Aliceykr/ImpedScope/README.md

# STM32 黑盒电路频响辨识

> 适用硬件：STM32H750XBH6，3.3 V 单电源 · 文档版本：2026-10-30，按当前源码、`.ioc`、Keil 工程和实际构建结果编写

## 1. 概述

本工程用一颗 STM32H750XBH6 测量未知一端口网络（DUT）的导纳：

- 外部信号源输出 **1 Vpp、1.65 V 直流偏置** 的正弦，接到 `Ui` 节点；
- DUT 接在 `Ui` 与运放虚地（1.65 V）之间，跨阻放大器把 DUT 电流转换成 `Uo`；
- 两路 ADC 同步采样 `Ui`、`Uo`，在选定频率上做单频 DFT，得到 `H = Uo/Ui`；
- 由 `Y = -H/R_eff`、`Z = -R_eff/H` 计算导纳、阻抗、G、B、φY；
- 固件自动在 **2 档频率（1 kHz / 10 kHz）** 中选择；反馈电阻为 **3 路继电器**，上电闭合 1.5 kΩ 档，可 b1 手动切档或 b2 打开自动量程。结果送串口屏，同时通过 USART3 输出调试日志。

测量范围（任务书指标）：`Re[Y]`、`Im[Y]`、`|Y|` 为 **0.1–10 mS**，误差 ≤10%；`φY` 为 **±90°**，误差 ≤5%。**默认 1.5 kΩ 档覆盖 0.188–1.88 mS；b1 可切 150 Ω / 15 kΩ 档，b2 自动量程会在三档间自动选。0.1–10 mS 全量程仍需按档标定（见 §8、§15）。**

## 2. 系统架构

### 2.1 模拟前端

```text
外部源 ── Ui ── DUT ──┬── 虚地 1.65 V（运放反相端）
 1 Vpp                │
 1.65 V 偏置          └── R（K1/K2/K3 之一，上电默认 K2 = 1.5 kΩ，b1 单击切档）
                             │
                        继电器触点（三路并联，高电平闭合）
                             │
                        运放输出 Uo（直流 1.65 V）
```

- 运放为 3.3 V 单电源、轨到轨；反相端由同相端偏置在 **1.65 V**，所以虚地和 `Uo` 的直流工作点都是 1.65 V。
- `Uo` 的交流摆幅设计为 0.15–1.5 V（围绕 1.65 V），即 0.15–3.15 V，落在 ADC 的 0–3.3 V 内。
- 三路独立继电器（高电平闭合）各串一只反馈电阻，并联在 `Uo` 与虚地之间：**K1=150 Ω / K2=1.5 kΩ / K3=15 kΩ**。
- 本版上电只闭合 **K2**，上电时 `R_eff = 1500 Ω`（b1 单击可切）；继电器接触电阻（<1 Ω）相对最小档 150 Ω 可忽略，按标称值使用。
- GPIO（**PE3/PE4/PE6**）只驱动继电器模块的逻辑输入，模块自带三极管/MOS 驱动与续流。

### 2.2 数字部分

- ADC1/ADC2 双 ADC 规则组同步采样，TIM6 TRGO 触发 300 kHz，CDR 打包 + DMA。
- UART4（921600）驱动串口屏：TX 阻塞发送，RX 单字节中断接收；USART3（921600）输出调试日志，应用层只使用 TX。
- 调试口为 SWD（PA13/PA14），没有调试 UART 复用。
- SPI1 配置为从机模式，通过 DMA 循环接收 FPGA 推送的测量帧，用于与 ADC+DFT 结果并行比对（见 §6）。

## 3. 工程结构

```text
9_30/
├─ USE/
│  ├─ measure.h/.c        测量核心：频率、ADC 采样与单频 DFT、H/Z/Y、标定、应用层循环
│  ├─ screen.h/.c         串口屏 UART4 协议、错误码、b0/b1/b2 按键、按键服务
│  ├─ relay_range.h/.c    三路继电器反馈电阻（b1 单击切档）
│  ├─ spi_slave.h/.c      SPI1 从机驱动：DMA 循环接收 FPGA 帧、CRC 校验、帧解析
│  └─ uart_debug.h/.c     USART3 调试日志（TX-only、环形缓冲、SPI/DFT 比对输出）
├─ Core/
│  ├─ Src/main.c          初始化、主循环（三个高层调用）
│  ├─ Src/usart.c         UART4（屏幕）+ USART3（调试）
│  ├─ Src/adc.c           ADC1/ADC2 双 ADC 同步配置
│  ├─ Src/tim.c           TIM6，TRGO 触发 ADC
│  ├─ Src/spi.c           SPI1 从机模式配置
│  ├─ Src/stm32h7xx_it.c  中断入口（含 ADC/UART4/USART3/SPI DMA）
│  └─ Src/gpio.c          CubeMX 生成的 GPIO
├─ Drivers/               STM32H7 HAL、CMSIS
├─ MDK-ARM/               Keil 工程（40 个源文件）
└─ 9_30.ioc               CubeMX 配置
```

`USE/` 是用户逻辑；CubeMX 重新生成时保留该目录。`relay_range` 和 `uart_debug` 已加入 Keil 的 `Application/User/USE` 组。

**代码分层说明**：
- `measure.c/h`：测量算法 + 应用层循环（Measure_Init, Measure_Service）
- `screen.c/h`：按键处理 + 屏幕显示（Screen_KeyService, Screen_Poll）
- `main.c`：只负责初始化和调用高层函数

## 4. 引脚与资源

| 资源 | 引脚 | 配置 | 用途 |
|---|---|---|---|
| ADC1 | PA0_C | `ADC1_INP0`，模拟 | `Ui` |
| ADC2 | PA1_C | `ADC2_INP1`，模拟 | `Uo` |
| UART4 | PC10 / PC11 | AF8，921600 8N1 | 串口屏 TX/RX |
| USART3 | PB10 / PB11 | AF7，921600 8N1，硬件 TX/RX 初始化；应用层 TX-only | 调试日志 |
| 继电器 K1/K2/K3 | PE3 / PE4 / PE6 | GPIO 推挽输出 | 量程选择（上电默认 K2，b1 单击切档） |
| TIM6 | 内部 | PSC=3，ARR=99 | 300 kHz TRGO |
| SWD | PA13 / PA14 | Serial Wire | 调试/下载 |
| HSE | PH0 / PH1 | 外部晶振 | 系统时钟 |
| LSE | PC14 / PC15 | 32.768 kHz | RTC 备选 |
| SPI1 | PB5 / PG11 / PG9 | MOSI/SCK/MISO | 从机接收 FPGA 数据（PG10 = NSS） |

- PB11 在硬件初始化中保留为 USART3_RX 复用脚，但应用层不调用 `HAL_UART_Receive_IT()` 或接收 DMA；USART3 实际只发送日志。
- PA4 不分配（原 DDS 片选已释放）。
- PG10 配置为 SPI1_NSS 硬件输入（FPGA 提供片选信号）。
- 所有模拟输入为 0–3.3 V 单端，无负压。

## 5. 主循环与数据流

```text
上电
  → HAL/时钟/GPIO/DMA/SPI1/UART4/USART3/ADC1/TIM6/ADC2
  → Screen_Init()            启动 UART4 接收（b0/b1/b2）
  → UartDebug_Init()          调试口就绪，输出 banner
  → Measure_Init()           CircuitID → Relay → ADC → SPI 从机 → 首次扫描
  → 主循环（每轮三个调用）
       Screen_KeyService()   处理按键，设置请求标志
       Measure_Service()     执行扫描或一次测量周期
       Screen_Poll()         每 500 ms 刷新屏幕
```

**架构说明**：
- `Screen_KeyService()`：处理 b0/b1/b2 按键，设置 Measure_RequestScan/NextRange/AutoRangeToggle
- `Measure_Service()`：运行期非阻塞状态机，每次调用执行一小步后立即返回（IDLE/SWEEPING/SWITCHING/MEASURING 四状态互斥）
- `Screen_Poll()`：刷新屏幕显示

**状态机架构**（v3.2 非阻塞改造）：

```
IDLE ──b0/自动──► SWEEPING ──done──► IDLE
  │                    ▲
  │b1                 │B1 abort
  ▼                    │
SWITCHING ─────────────┘
  │
  │done
  ▼
MEASURING ──window ready/timeout──► IDLE
```

- 所有状态在每次 `Measure_Service()` 调用时先检查按键请求，按键响应时间 < 10 ms
- 运行期 ADC 窗口等待、频率扫描、切档均为非阻塞，主循环单次迭代 < 5 ms；`Measure_Init()` 的首次扫描在启动路径中循环等待完成，这是初始化例外。

**按键行为**：
- b0 单击 → 重扫频率（队列中尚未消费的重复 b0 合并为一个待处理事件）
- b1 单击 → 切换继电器档位（1.5k → 15k → 150 → 循环）；自动量程开启时先关闭自动再切档
- b2 单击 → 打开/关闭**自动量程**（见 §8.3），`t10` 末尾出现 ` A` 表示已开启

- 反馈电阻上电固定 1.5 kΩ；b1 单击可循环切档，切档后 `CircuitID_SetFeedbackResistor()` 同步 `R_eff`、丢弃当前窗口并重开。
- 计算失败/超时会清结果，屏幕显示 `-`，不显示陈旧读数。
- b1 在窗口等待期间可提前响应，扫描期间按 b1 立即退出扫描并切档，不闪 E04。

## 6. 测量原理

### 6.1 采样窗口

```text
N = round(100 × fs / f)，限制在 [256, 400000]
fs = 300 kHz
```

窗口覆盖 100 个信号周期：

| f | N | 窗口时长 |
|---|---|---|
| 100 Hz | 300000 | 1 s |
| 300 Hz | 100000 | 333 ms |
| 1 kHz | 30000 | 100 ms |
| 3 kHz | 10000 | 33.3 ms |
| 10 kHz | 3000 | 10 ms |

窗口时长远小于 `MEASURE_WAIT_TIMEOUT_MS = 1500 ms`；100 Hz 的 1 s 也留了 500 ms 余量。

### 6.2 单频 DFT

```text
ω = 2π f / fs
S = Σ (x_n − x̄) · e^(−j ω n)，n = 0 … N−1
x̄ = 窗口平均值（去直流）
|U| = 2 |S| / N        （ADC 码值，峰值）
```

- `S_i` 对应 `Ui`（ADC1），`S_o` 对应 `Uo`（ADC2）。
- 两路共用同一个 N 和同一个块序号，`H = Uo/Ui` 与归一化无关。

### 6.3 相干性判据

```text
kappa = |U| / (sqrt(2) · RMS_ac)
```

- 纯单频：`kappa = 1.0`；纯噪声：`kappa ≈ sqrt(2/N)`（N=30000 时约 0.008）。
- `kappa < CIR_MIN_COHERENCE`（0.2）→ `Ui` 报 E14、`Uo` 报 E15。
- 幅值下限：`|Ui| < 4` 码 → E04；`|Uo| < 4` 码 → E05。两个门限是占位值，待实测调整。

### 6.4 传递函数、阻抗、导纳

```text
H = Uo / Ui
Z = -R_eff / H
Y = -H / R_eff
G = Re[Y]，B = Im[Y]
```

- `H` 的 dB/相位由 `20·log10(|H|)` 和 `atan2(H_im, H_re)` 得到。
- `|H| < CIR_H_MIN_MAG`（1e-6）→ E08；Z/Y 非有限 → E09。
- `R_eff` 由 `relay_range` 提供，上电恒为 1500 Ω；b1 单击可切为 150/1500/15000 Ω，见第 8、9、13 节。
- 两路 ADC 的增益/相位差由 `s_calib[]` 修正，见第 13 节。

### 6.5 数值示例

1 µF 电容，`R_eff = 115 Ω`（15 Ω 档），1 kHz，源 1 Vpp（`Ui` 峰值 0.5 V）：

```text
Y   = jωC ≈ j 6.283 mS
|Y| ≈ 6.283 mS，φY = +90°，G = 0，B ≈ +6.283 mS
H   = -Y·R_eff ≈ -j 1.571（4.08 dB，-90°）
Uo 峰值 = 0.5 V × 1.571 ≈ 0.785 V（不削顶）
|Z| = 1/|Y| ≈ 159 Ω
```

## 7. 自动选频

`FreqScanStep()` 在启动和按 b0 时推进扫描：

- 候选顺序：`1 kHz, 10 kHz`；
- 每个候选开一个窗口，算 `Ui` 的单频幅值 `ui_mag` 和相干性 `ui_coh`；
- 打分 `score = ui_mag × ui_coh`，要求 `ui_mag > CIR_INPUT_MIN_AMP` 且 `ui_coh > 0.5`；
- 取最高分；某档 `ui_coh > 0.95` 时提前结束；
- 全部不合格时回到 1 kHz 并返回 0，主循环报 E04。

选频只依赖 `Ui`，与反馈电阻无关；量程默认 1.5 kΩ，由 b1 单击手动切换，无需选档。`Measure_SetFrequency()` 可覆盖频率，范围 100–100000 Hz；外部源必须同步到当前频率。运行期扫描由 `Measure_Service()` 分步推进，扫描期间 b1 可中止扫描；两档扫描的采样等待总时长约 0.11 s，但不会在一次主循环调用中阻塞。

## 8. 继电器量程（三档，上电默认 1.5 kΩ）

### 8.1 三路继电器与档位

| 通道 | GPIO | 电阻 | 上电后状态 | 覆盖 \|Y\|（Uo 0.15–1.5 V，参考） |
|---|---|---|---|---|
| K1 | PE3 | 150 Ω | 断开（低） | 1.2–12 mS |
| K2 | PE4 | 1.5 kΩ | **闭合（高，默认档）** | 0.188–1.88 mS |
| K3 | PE6 | 15 kΩ | 断开（低） | 19.9–198.7 µS |

- 高电平 = 继电器线圈得电 = 触点闭合；低电平/GND = 断开。三路**独立**，任意时刻最多闭合一路。
- 每路：`Uo → 继电器触点 → 反馈电阻 → 虚地（1.65 V）`，三路并联；触点只承受小信号（≤1.5 V、≤5 mA）。
- 继电器接触电阻通常 0.05–0.5 Ω，相对最小档 150 Ω 可忽略，`R_eff` 直接按标称值。
- GPIO 只驱动继电器模块的逻辑输入（模块自带三极管/MOS 驱动与续流），不要直接驱动裸线圈。

### 8.2 上电时序与运行期切档

- `MX_GPIO_Init()`（CubeMX 生成）配 PE3/PE4/PE6 为推挽输出并写低；`Relay_Init()` 只做上电时序：三路全低（断开）→ 等 10 ms 释放 → 只把 PE4 拉高（K2 = 1.5 kΩ）→ 等 10 ms 吸合。
- `CircuitID_SetFeedbackResistor(Relay_GetOhm())` 同步固定 `R_eff = 1500 Ω`，与 `s_calib`（Rf=1500）和 `CIR_FEEDBACK_RESISTOR_OHM` 对齐。
- **不做自动量程**（默认）；运行期切档由 b1 单击触发（`Relay_NextAsync()`，1.5k → 15k → 150 → 1.5k 循环）。b2 可打开自动量程，见 §8.3。
- 上电三路全断到 K2 闭合之间 TIA 开环、`Uo` 可能撞轨；`Relay_Init()` 在 `ADC_Sampler_Init()` 之前完成，不会采到无效窗口。

### 8.3 自动量程（b2 开关）

- b2 单击切换：**按一下开、再按一下关**；开启后 `t10` 显示 `R:1.5k A`。
- 每完成一个窗口评估一次，按 **`Uo` 峰值最接近半量程（0.8 V）** 选档：
  ```
  Uo_pred(i) = Uo_meas × R[i] / R[cur]        （同一 DUT、同一频率下 |Y| 不变）
  在 Uo_pred ≤ MEASURE_AR_MAX_V(1.5 V) 的候选里，选 |ln(Uo_pred / 0.8)| 最小的档
  ```
  `Uo` 落在半量程，意味着 ADC 用了约 50% 可用摆幅，同时 `|Y|·Rf` 也处在合适量级——两个“最佳范围”是同一个条件。
- **降增益立即执行**（削顶时 `Uo` 饱和、外推不可信，只退一档）；**升增益需连续 2 个窗口确认**，防止在临界点来回跳。
- `Uo` 低于 `MEASURE_AR_MIN_CODE`（4 码）视为没有信号，不参与选档，交给 `CircuitID_Compute()` 报 E05。
- 三档都放不下（`|Y|` > 约 12 mS 或 < 约 20 µS）时选最接近的档继续测，E19/E20/E05 照常上报，自动模式保持开启。
- 自动模式下按 b1：**先关闭自动，再切到下一档**（手动接管）。
- 复位后自动关闭、回到 1.5 kΩ；运行期切档使用 `Relay_NextAsync()`，先释放、等待 10 ms，再吸合目标档并等待 10 ms。两个等待阶段由 `SWITCHING` 状态分散到多次主循环调用中，不阻塞主循环；切档完成后丢弃当前窗口并重新启动采样。

## 9. SPI 从机与双路并行（FPGA 数据接收）

### 9.1 概述

SPI1 配置为从机模式，通过 DMA 循环接收 FPGA 推送的测量帧。每个测量周期：
- DFT 值照常输出到串口屏
- SPI 帧换算成 Y 并与 DFT 值比对，结论只写 USART3 日志
- SPI 超时/持续坏帧 → 报错误码 E21，DFT 路径不受影响（双路并行）

### 9.2 硬件连接

```text
FPGA (Master)                    STM32H750 (Slave)
  MOSI  ───────────────────────►  PB5   (SPI1_MOSI，从机时是输入)
  SCK   ───────────────────────►  PG11  (SPI1_SCK，从机时是输入)
  CS    ───────────────────────►  PG10  (SPI1_NSS，硬件输入，低有效)
  MISO  ◄───────────────────────  PG9   (可选；本阶段 H7 不发，保持高阻/悬空)
  GND   ────────────────────────  GND   (必须共地)
```

### 9.3 帧协议

- 单位：16 位字（SPI1 配的是 16 位帧）
- 位序：MSB first；32 位量拆成高字在前、低字在后
- 一帧 = 10 个字 = 20 字节
- 每帧独立，帧间无间隔要求；FPGA 只需保证 CS 一帧拉低一次

**⚠️ 关键：CS 不能用来对齐帧**

固件不会在 CS 上升沿重置 DMA 位置 —— DMA 只是按字计数，4 帧循环。

- 帧边界靠"每帧固定 10 字"维持，不靠 CS
- 一旦多/少一个 16 位字，后面全错位，只能靠"连续 4 帧失败 → HAL_SPI_Abort + 重挂 DMA"恢复
- **FPGA 必须保证 CS 拉低的整个区间里恰好发 160 个 SCK，不能中间断**

**示例帧**（`|H|=1.500000`，`φ=-11.860°`，`f=1000`，`seq=1`，`flags=0x0005`）：

```text
A55A 0001 0005 0000 03E8 0016 E360 FFFF D1AC <crc>
```

- `1.5e6 = 0x0016E360` → `word5=0x0016`、`word6=0xE360`
- `-11860 = 0xFFFFD1AC` → `word7=0xFFFF`、`word8=0xD1AC`
- `flags=0x0005` = bit0（有效）+ bit2（频率有效）
- `<crc>` 由 FPGA 按下方规则计算

| Word | 字段 | 类型 | 说明 |
|---|---|---|---|
| 0 | `HEAD` | `0xA55A` | 帧头，固定 |
| 1 | `seq` | u16 | 帧序号，每帧 +1，溢出回绕 |
| 2 | `flags` | u16 | bit0=本帧有效；bit1=FPGA 侧削顶；bit2=频率字段有效 |
| 3 | `f_hi` | u16 | 频率 Hz，高 16 位 |
| 4 | `f_lo` | u16 | 频率 Hz，低 16 位 |
| 5 | `mag_hi` | u16 | `\|H\| × 1e6`（u32），高 16 位 |
| 6 | `mag_lo` | u16 | 同上，低 16 位 |
| 7 | `phi_hi` | u16 | `φH`，单位毫度（int32，补码），高 16 位 |
| 8 | `phi_lo` | u16 | 同上，低 16 位 |
| 9 | `crc` | u16 | CRC-16/CCITT-FALSE，初值 0xFFFF，多项式 0x1021 |

**⚠️ CRC 字节序：必须按线上顺序（大端）计算**

Cortex-M7 是小端，`0xA55A` 在内存里是 `5A A5`，但 SPI 线上 MSB first 发的是 `A5 5A`。

固件算 CRC 时按**线上字节顺序**（大端）喂数据，FPGA 侧必须保持一致：

- **正确做法**：把 10 个字（word0..word9）按字节流 `A5 5A 00 01 ...` 喂给 CRC 函数
- **错误做法**：按内存小端序（`5A A5 ...`）喂 CRC —— 会导致"帧头对、CRC 全错"，容易误判成时序问题

FPGA 实现时：每个 16 位字先发高字节、再发低字节，CRC 按这个字节流顺序计算。

### 9.4 调试输出

通过 USART3 输出 SPI 调试信息，编译期分级宏控制：

| 等级 | 输出内容 | 默认 |
|---|---|---|
| LEVEL=0 | 全关（量产） | ✗ |
| LEVEL=1 | 初始化 + 错误 + 每秒统计（稳态约 1 行/秒） | ✓ |
| LEVEL=2 | 额外按时间节流打印 SPIRX（联调用，10 行/秒） | ✗ |
| LEVEL=3 | 再额外 dump SPIRAW 原始字（查字对齐/位序） | ✗ |

**关键约束**：
- 限速靠时间，不靠帧数（避免高帧率时刷爆日志缓冲）
- DMA 回调里只累加计数、置标志，所有打印只在主循环上下文发出
- 联调完必须把等级降回 1（避免挤占测量日志）

### 9.5 测试用例

| # | 用例 | 预期 |
|---|---|---|
| S1 | FPGA 持续发帧 | `ok` 递增、`err/ovr=0`；USART3 每测量周期一行 `SPI ...` |
| S2 | 拔掉 FPGA | 200 ms 后屏上出现 E21，DFT 结果照常刷新；插回后 E21 自动消失 |
| S3 | 故意发错 CRC | `err` 递增，坏帧不被采用（`seq` 不前进） |
| S4 | 先断后接导致字错位 | 连续 4 帧失败后自动重同步，恢复出数 |
| S5 | 接 1 kΩ 0.1% 电阻 | `dY_permille` < 20（2%）、`dP_mdeg` < 200（0.2°） |
| S6 | 切档（b1）后再测 | SPI 结果随之变化，无异常帧 |
| S7 | 自动量程开启（b2） | 行为不变，SPI 只记录 |
| S8 | 长时间运行 30 min | 无 OVR 累积、无内存越界 |

## 10. 串口屏（UART4）

- UART4，**921600 8N1**，PC10 TX / PC11 RX。TX 使用 `HAL_UART_Transmit()` 阻塞发送；RX 使用 `HAL_UART_Receive_IT()` 单字节中断接收；DMA 不使用。
- 每 500 ms 发一整帧 `t0`–`t10`，每条 `控件名.txt="值"` + `FF FF FF`；条间留 2 ms 给 HMI 重绘。
- 屏幕只显示，频率由固件自动选择；b0 单击 = 强制重扫，b1 单击 = 切换继电器档位，b2 单击 = 自动量程开关。

| 控件 | 内容 | 示例 |
|---|---|---|
| `t0` | 频率（Hz） | `f:1000`，无结果显示 `f:-` |
| `t1` | `\|Y\|`（mS） | `Y:1.000` |
| `t2` | φY（°） | `P:-12.34` |
| `t3` | G = Re[Y]（mS） | `G:0.977` |
| `t4` | B = Im[Y]（mS） | `B:-0.213` |
| `t5` | 阶段或最近错误 | `stage:LOOP`、`stage:E12 WINDOW_TIMEOUT x12` |
| `t6` | 心跳，每帧 +1 | `beat:1234` |
| `t7` | `Ui` 交流有效值（V）与 kappa | `Ui:0.1234V k:0.98` |
| `t8` | `Uo` 交流有效值（V）与 kappa | `Uo:0.0988V k:0.97` |
| `t9` | H 的幅值（dB） | `H:-3.97dB` |
| `t10` | 当前反馈电阻档位 | `R:1.5k` |

- `t1`–`t4` 依赖 `CIR_DUT_TOPOLOGY=1`；设为 0（只算 H）时这四行固定显示 `-`。
- 阶段顺序：`BOOT → CLK → PERIPH → MODULE → SCAN → LOOP`；`BOOT`/`CLK` 在 UART 就绪前，屏幕不可见；`PERIPH` 起可见，且保持约 150 ms。
- 按键协议为**单字节**（`0x01`/`0x02`/`0x03`），UART4 接收中断直接映射成事件入队，`Screen_PollKey()` 每轮出队一个；运行期即使正在等待 DFT 窗口，按键也保留在队列中，不依赖阻塞式扫描：
  - b0：`0x01`（`printh 01`）：单击强制重扫频率，档位不变；
  - b1：`0x02`（`printh 02`）：单击切换继电器档位（1.5k → 15k → 150 → 1.5k），频率不变；切档由 `Relay_NextAsync()` 推进，完成后调用 `CircuitID_SetFeedbackResistor()` / `Screen_ClearResult()` / `Screen_ClearError()` / `Screen_FlushRange()` / `ADC_Sampler_Restart()`；
  - b2：`0x03`（`printh 03`）：单击打开/关闭自动量程（`t10` 末尾出现/去掉 ` A`）。
- 100 ms 防抖窗口从上一次通过识别的按键事件开始计时：小于 100 ms 的重复事件丢弃，达到 100 ms 的新事件允许通过；因此同一次点击里的重复字节（如 `03 03 03`）通常只算一次，但**不要混发不同字节**（如 `01 01 02`）作为一组协议。
- b0 额外做合并/去重：尚未出队时只保留一个待处理事件；事件出队时清除 pending 标志，因此后续 b0 仍可再次触发重扫。
- b1 只在按下事件发送一次；HMI 释放事件必须为空，否则一次点击会触发两次。
- 档位在 `t10` 显示为 `R:150 / R:1.5k / R:15k`；切档时 `Screen_FlushRange()` 立即补发 `t10`，不等 500 ms 整帧。`Screen_SetActiveFreq()` 只更新当前频率、清上一频率结果并强制下一帧刷新。

## 10. 调试串口（USART3）

- **USART3，PB10 TX / PB11 RX（AF7），921600 8N1**；硬件初始化为 TX/RX，但应用层只调用 `HAL_UART_Transmit_IT()`，不启动 USART3 接收流程，因此 PB11 浮空不会形成应用层 RXNE 接收中断路径。
- 当前实际 NVIC 配置为：`USART3_IRQn=(0,0)`、`UART4_IRQn=(0,0)`、`SPI1_IRQn=(0,0)`、`DMA1_Stream2_IRQn=(0,0)`、`DMA1_Stream1_IRQn=(0,0)`、`DMA1_Stream0_IRQn=(1,0)`；ADC 错误中断在运行时设置为 `ADC_IRQn=(5,0)`。这与“USART3=5、DMA=0”的设计意图并不完全一致，属于优先级配置未完全落地，当前没有证据表明会静默破坏 DFT。
- `DMA_PRIORITY_LOW` 是 DMA 控制器内部优先级，不等同于 NVIC 抢占优先级。
- 发送：1024 字节环形缓冲 + `HAL_UART_Transmit_IT()`；主循环只拷贝，不阻塞；缓冲满整行丢弃并计数。
- 速率：每次有效测量一行，最小间隔 `UART_DEBUG_MIN_INTERVAL_MS = 200 ms`（5 Hz）。
- 只发不收，没有下行命令；标定写入/表格导出仍需另加协议。

日志格式（CSV，整数单位，不用 `%f`）：

```text
f=1000,Y_uS=1000,P_mdeg=-12300,G_uS=977,B_uS=-213,H_dB_x100=408,H_deg_x100=16770,R_ohm=1500,range=1,Ui_rms_mV=354,Uo_rms_mV=566
```

- `Y_uS/G_uS/B_uS`：µS（1 mS = 1000 µS）
- `P_mdeg`：毫度（-12.3° → -12300）
- `H_dB_x100 / H_deg_x100`：dB×100、度×100
- `R_ohm`：当前 `R_eff`
- `range`：0=150 Ω、1=1.5 kΩ、2=15 kΩ（当前档位，随切档变化）
- `Ui_rms_mV / Uo_rms_mV`：去直流后的交流有效值（mV）

上电 banner：

```text
BOOT 9_30 debug uart 921600
```

接线：USB-TTL 的 **RX → PB10**，**GND → GND**。若 921600 误码，改 `.ioc` 的 `USART3.BaudRate` 和 `usart.c` 中的 921600 为 115200。USART3 出错时 `screen.c` 的 `HAL_UART_ErrorCallback()` 会清理标志并调用 `UartDebug_OnError()` 重启发送。

## 11. ADC 采样

### 11.1 通道

| 通道 | 引脚 | ADC 通道 | 含义 |
|---|---|---|---|
| ADC1（主） | PA0_C | `ADC1_INP0` | `Ui` |
| ADC2（从） | PA1_C | `ADC2_INP1` | `Uo` |

`_C` 为直连快速通道，经 SYSCFG 模拟开关接入；PA0_C/PA1_C 与普通 PA0/PA1 是两个焊盘。

### 11.2 时序

- 双 ADC 规则组同步模式（`ADC_DUALMODE_REGSIMULT`），16 位，`32_10_BITS` 打包。
- TIM6 TRGO 上升沿同时启动两路；PSC=3、ARR=99、120 MHz → **300 kHz**。
- 采样时间 **1.5 个 ADC 周期**（37.5 MHz 下 40 ns）；16 位转换 8.5 周期，总计约 267 ns，远小于 3.33 µs 触发周期。
- ADC 时钟 PLL2 75 MHz / 2 = **37.5 MHz**。HSE=25 MHz 时，PLL2 输入为 `25/2=12.5 MHz`，VCO 为 `12.5×12=150 MHz`，P/Q/R 输出均为 75 MHz。
- 只有 ADC1 的 DMA（DMA1_Stream2，32 位字、循环）搬运 CDR；ADC2 的 DMA 配置保留但同步模式下不启动。
- 每半个缓冲区 64 对样本回调一次。

### 11.3 初始化与保护

- `ADC_Sampler_Init()`：回读 CCR 校验同步模式/打包格式（不符返回 2 → E16 致命）→ 两路 offset/linearity 校准 → `HAL_ADCEx_MultiModeStart_DMA()` → 使能 `ADC_IRQn` → 启动 TIM6。
- OVR（E17）或 DMA 错误（E18）会作废当前窗口；由 `HAL_ADC_ErrorCallback()` 置弃窗标志，`ADC_Sampler_TryFinish()` 丢弃，不置 ready。
- 溢出/DMA 错误不终止测量，主循环等下一个干净窗口。

### 11.4 接口

| 函数 | 说明 |
|---|---|
| `ADC_Sampler_Init()` | 校准、启动同步转换和 TIM6；返回 0/1/2 |
| `ADC_Sampler_SetFrequency(f)` | 设定频率并开新窗口；同频不重开；非法返回 0 |
| `ADC_Sampler_GetWindow(&w)` | 取出已完成窗口；无新窗口返回 0 |
| `ADC_Sampler_Restart()` | 以当前频率强制重开窗口；换档后调用 |
| `ADC_Window_t` | `frequency_hz`、`sample_count`、`ui_re/im`、`uo_re/im`、`ui_rms/uo_rms`、`clip` |

改采样率时必须同时改 TIM6 的 PSC/ARR 和 `ADC_SAMPLER_RATE_HZ`，否则 DFT 频率轴静默错位。

### 11.5 DMA 内存位置与中断优先级

- 当前命令行构建使用的 scatter file 将 RW/ZI 分配到 `RW_IRAM1=0x20000000`（DTCM）和 `RW_IRAM2=0x24000000`（AXI SRAM）。
- 实际 armlink map 中，ADC 双缓冲 `adc_pair_buf` 位于 `0x24000084`，SPI DMA 缓冲 `s_dma_buf` 位于 `0x240007e4`，均在 AXI SRAM；本次构建的 DTCM 区没有放入这些关键 DMA 缓冲。
- 结论：当前不存在“DMA buffer 落在 DTCM、DMA1 不可达”的问题，不需要因此修改硬件或强行增加 section 属性。
- PLL2 VCO 当前为 **150 MHz**，处于 HAL 注释给出的 `RCC_PLL2VCOMEDIUM` 范围 `150–420 MHz` 的下边界；代码计算和当前 HAL 范围允许。仍建议上板时结合目标芯片数据手册、温度和电源条件确认锁定稳定性，当前不据此修改配置。
### 11.6 削波检测

- 统计窗口内贴边样本：码值 `≤ CIR_CLIP_LOW_CODES (64)` 或 `≥ CIR_CLIP_HIGH_CODES (65471)`；
- 贴边比例 > `CIR_CLIP_MAX_PERMILLE (1%)` → `Ui` 报 E19、`Uo` 报 E20；
- 削顶时波形仍完整，结果照常计算/显示，但提示不可信；E17/E18 才是必须弃窗的失效。
- 局限：只能抓 ADC 端贴边；运放先饱和（ADC 尚未贴边）抓不到，仍需把前端偏置/幅度做对。

## 12. 参数配置

| 宏 | 文件 | 默认 | 说明 |
|---|---|---|---|
| `ADC_SAMPLER_RATE_HZ` | `measure.h` | 300000 | DFT 频率轴（必须与 TIM6 一致） |
| `ADC_SAMPLER_PAIRS_PER_HALF` | `measure.h` | 64 | 每个 DMA 半缓冲的采样对数 |
| `ADC_SAMPLER_WINDOW_CYCLES` | `measure.h` | 100 | 窗口覆盖的信号周期数 |
| `ADC_SAMPLER_WINDOW_MIN/MAX` | `measure.h` | 256 / 400000 | 窗口点数上下限 |
| `ADC_SAMPLER_VREF_V` | `measure.h` | 3.3 | VREF+/VDDA，只影响 t7/t8 电压 |
| `CIR_DUT_TOPOLOGY` | `measure.h` | 1 | 1=算 Z/Y；0=只算 H |
| `CIR_FEEDBACK_RESISTOR_OHM` | `measure.h` | 1500.0 | 固定反馈电阻（relay_range 同步后使用） |
| `CIR_INPUT_MIN_AMP` / `CIR_OUTPUT_MIN_AMP` | `measure.h` | 4.0 | 幅值下限（码值，占位） |
| `CIR_MIN_COHERENCE` | `measure.h` | 0.2 | 相干性下限 |
| `CIR_H_MIN_MAG` | `measure.h` | 1e-6 | `|H|` 下限 |
| `CIR_CLIP_LOW/HIGH_CODES` | `measure.h` | 64 / 65471 | 贴边码值 |
| `CIR_CLIP_MAX_PERMILLE` | `measure.h` | 10 | 贴边比例上限（1%） |
| `RELAY_COUNT` | `relay_range.h` | 3 | 继电器档位数 |
| `RELAY_DEFAULT_INDEX` | `relay_range.h` | 1 | 默认档（K2 = 1.5 kΩ） |
| `RELAY_SETTLE_MS` / `RELAY_RELEASE_MS` | `relay_range.h` | 10 / 10 | 吸合建立 / 释放等待（ms） |
| `Relay_SetAsync()` / `Relay_NextAsync()` | `relay_range.h` | — | 运行期非阻塞切档 / 切到下一档（b1 单击触发） |
| `MEASURE_AR_TARGET_V` | `measure.h` | 0.8 | 自动量程目标 `Uo` 峰值（半量程） |
| `MEASURE_AR_MAX_V` | `measure.h` | 1.5 | 自动量程允许的最大预测 `Uo`（超过就判为会削顶） |
| `MEASURE_AR_MIN_CODE` | `measure.h` | 4.0 | 低于此码值视为没信号，不参与选档 |
| `MEASURE_AR_UPSHIFT_WINDOWS` | `measure.h` | 2 | 升增益需要的连续确认窗口数 |
| `UART_DEBUG_ENABLE` | `uart_debug.h` | 1 | 调试日志开关 |
| `UART_DEBUG_MIN_INTERVAL_MS` | `uart_debug.h` | 200 | 日志最小间隔（ms） |
| `UART_DEBUG_TX_BUFFER_SIZE` | `uart_debug.h` | 1024 | 发送环形缓冲（字节） |
| `MEASURE_WAIT_TIMEOUT_MS` | `main.c` | 1500 | 单窗口等待上限（ms） |
| `SCREEN_REFRESH_PERIOD_MS` | `screen.h` | 500 | 串口屏刷新周期（ms） |

## 13. 标定

### 13.1 反馈电阻

上电默认闭合 K2（1.5 kΩ），`R_eff` 由 `CircuitID_SetFeedbackResistor(Relay_GetOhm())` 同步；
1.5 kΩ 档已标定，继电器接触电阻（<1 Ω）可忽略。b1 切到 150 Ω / 15 kΩ 档后需按档重标 `R_eff`。

### 13.2 两路直通 H_thru

把 `Ui` 和 `Uo` 短接到同一信号源，理论上 `H = 1`（0 dB、0°）；实测偏差就是两路增益比与相位差：

```text
H_true(f) = H_meas(f) / H_thru(f)
mag_ratio = 1 / |H_thru|
phase_deg = angle(H_thru)
```

- 1.5 kΩ 档按**逐频点**做即可；切到 150 Ω / 15 kΩ 档后 C_off 随档位变化，这两档的 H_thru 需逐档重做。
- 标定时窗口长度、采样率、频率必须与实际测量一致。

### 13.3 当前标定表

`s_calib[]` 目前有两项，在 **1.5 kΩ 反馈**（即本版默认档）下测得，直接适用：

| 频率 | mag_ratio | phase_deg |
|---|---|---|
| 1 kHz | 1.009 | -1.186° |
| 10 kHz | 1.031 | -11.559° |

`Calib_Lookup()` 是**就近取值、不插值**，只标 1k/10k 时 100/300/3k 会取最近点。

## 14. 错误码

非致命错误由 `Screen_ReportError()` 计数，`t5` 显示最近错误和累计次数；新阶段/新错误覆盖显示。致命错误由 `Screen_Fatal()`/`Error_Handler()` 触发，关中断后阻塞发送，`t5` 锁定。

| 码 | 名称 | 位置 | 触发条件 | 类型 |
|---|---|---|---|---|
| E01 | HAL_INIT | `MX_*_Init()`、`ADC_Sampler_Init()` | 外设初始化/校准/DMA 启动失败 | 致命 |
| E02 | CIR_CFG | `measure.c` | `R_eff ≤ 0`、频率 0、窗口空 | 非致命 |
| E03 | CIR_NAN_IN | `measure.c` | Ui/Uo 分量非有限 | 非致命 |
| E04 | CIR_UI_LOW | `measure.c` | `\|Ui\| < CIR_INPUT_MIN_AMP` | 非致命 |
| E05 | CIR_UO_LOW | `measure.c` | `\|Uo\| < CIR_OUTPUT_MIN_AMP` | 非致命 |
| E06 | CIR_H_NAN | `measure.c` | H 非有限 | 非致命 |
| E07 | CIR_OUT_NAN | `measure.c` | 频率/dB/相位输出非有限 | 非致命 |
| E08 | CIR_H_LOW | `measure.c` | `\|H\| < CIR_H_MIN_MAG` | 非致命 |
| E09 | CIR_ZY_NAN | `measure.c` | Z/Y 非有限 | 非致命 |
| E10 | UART_TX | `screen.c` | UART4 发送失败 | 非致命 |
| E11 | UART_BUSY | — | 保留：当前 UART4 TX 为阻塞发送，不走忙状态错误路径 | — |
| E12 | WINDOW_TIMEOUT | `main.c` | 等 ADC 窗口超时 | 非致命 |
| E13 | — | — | 已停用，保留编号 | — |
| E14 | CIR_UI_INCOH | `measure.c` | `Ui` 非单频（kappa < 0.2） | 非致命 |
| E15 | CIR_UO_INCOH | `measure.c` | `Uo` 非单频（kappa < 0.2） | 非致命 |
| E16 | ADC_DUAL_MODE | `measure.c` | 双 ADC 同步/打包格式回读不符 | 致命 |
| E17 | ADC_OVR | `measure.c` | ADC 溢出，弃窗 | 非致命 |
| E18 | ADC_DMA | `measure.c` | ADC DMA 错误，弃窗 | 非致命 |
| E19 | ADC_CLIP_UI | `measure.c` | `Ui` 削顶 | 非致命 |
| E20 | ADC_CLIP_UO | `measure.c` | `Uo` 削顶 | 非致命 |
| E21 | SPI_LINK | `measure.c` | SPI 从机链路超时（>200 ms 无有效帧） | 非致命 |

时钟配置失败发生在 UART 就绪前，屏幕无法显示，只能用调试器定位。

## 15. 已知限制

- **默认只测 1.5 kΩ 档**：覆盖约 0.188–1.88 mS；b1 单击可切 150 Ω / 15 kΩ 档（约 1.2–12 mS / 19.9–198.7 µS），0.1–10 mS 全量程仍需按档标定 `R_eff`。
- **继电器模块依赖外部硬件**：必须高电平闭合、GPIO 只接模块逻辑输入；若模块低有效或上电吸合，需改硬件或在 `Relay_Write()` 反转（见 §8）。
- **上电三路全断 → TIA 开环**：`Relay_Init()` 必须在 `ADC_Sampler_Init()` 之前完成；复位/上电期间模块输入建议加 10 kΩ 下拉。
- **自动选频耗时**：扫描两档约 0.11 s。
- **外部源频率/直流不在固件控制内**：源频率偏离会导致 κ 下降/相位误差；源直流中点必须是 1.65 V，否则 DUT 上会有 1.65 V 直流，TIA 可能饱和。
- **幅值门限是占位值**：`CIR_INPUT_MIN_AMP`/`CIR_OUTPUT_MIN_AMP = 4` 码，需按实际噪声调整。
- **调试串口只发不收**：USART3 应用层只使用 TX，没有下行命令；PB11 虽保留硬件 RX 复用，但未启动接收流程。
- **档位在 t10 显示**：`R:150 / R:1.5k / R:15k`（当前档，切档后立即更新）；更细的 `R_eff` 可从 USART3 日志的 `range`/`R_ohm` 看。
- **两路增益/相位只标了 1.5 kΩ 档**：默认档 `s_calib` 直接适用；b1 切到 150 Ω / 15 kΩ 档后绝对值只可信到相对变化，需按档重标。
- **扫描期间按键**：运行期扫描由 `FreqScanStep()` 分步推进，b1 可中止扫描并切档；尚未出队的重复 b0 会合并为一个待处理事件。

## 16. 编译与维护

- Keil MDK-ARM 打开 `MDK-ARM/9_30.uvprojx`；ArmClang V6.24（`.uvprojx` 的 `pArmCC` 已钉到该版本）。
- CubeMX 6.18，HAL FW 1.13；系统时钟 480 MHz，HCLK 120 MHz，APB 60 MHz；ADC 37.5 MHz；SPI1 75 MHz。
- 当前 **40 个源文件**，含 `relay_range.c`、`uart_debug.c`、`spi_slave.c`。
- 命令行构建：

```bash
bash .ccg-build/build.sh <outdir>
```

CubeMX 重新生成后检查：

1. Keil 工程仍包含 `measure.c`、`screen.c`、`relay_range.c`、`uart_debug.c`，头文件路径含 `../USE`。
2. `.ioc`：PE3/PE4/PE6 为 `GPIO_Output`（标签 `RELAY_K1/K2/K3`）；PB10 为 `USART3_TX`；UART4/USART3 均 921600；UART4/USART3 全局中断使能。
3. `main.c` USER CODE 区：
   - USER CODE BEGIN 2: `Screen_Init()`, `UartDebug_Init()`, `Measure_Init()`
   - USER CODE BEGIN WHILE: `Screen_KeyService()`, `Measure_Service()`, `Screen_Poll()`
4. `adc.c` 的 `ADC_DUALMODE_REGSIMULT`/`DualModeData`/`TwoSamplingDelay` 仍在 `USER CODE BEGIN ADC1_Init 2` 区；ADC1 的 DMA 为 Word 对齐。
5. TIM6 的 PSC/ARR 与 `ADC_SAMPLER_RATE_HZ` 一致；SPI1 为从机模式，DMA 循环接收 FPGA 帧。
6. `relay_range.c`、`uart_debug.c`、`spi_slave.c` 在 `Application/User/USE` 组。

**代码架构说明**：
- `main.c` 只负责初始化和调用三个高层函数
- 按键逻辑在 `screen.c` 的 `Screen_KeyService()`
- 测量逻辑在 `measure.c` 的 `Measure_Service()`
- 屏幕刷新在 `screen.c` 的 `Screen_Poll()`

## 17. 验证状态

已通过：

- ArmClang 命令行编译 + 链接：**40 个源文件，0 个编译/链接错误**；Program Size：Code=58826、RO-data=2542、RW-data=28、ZI-data=5540。构建过程中有 legacy armasm deprecated 提示，不影响生成固件。
- `.ccg-build/verify.sh` 全量检查通过（PASS），包括 40 个源文件、当前 scatter 内存布局、关键外设配置和生成代码一致性检查。
- `.ioc` 与代码的引脚/实例一致性检查：PE3/PE4/PE6（`RELAY_K1/K2/K3`）、PB10/USART3、PC10/11/UART4。
- 固件源码（`USE/`、`Core/`）静态检查：无 `analog_switch` / `Switch_*` / `SW_ENABLE` / `Screen_TakeRefreshKey` 残留。
- **代码架构重构完成**：main.c 瘦身为三个高层调用，按键/测量/显示逻辑分层清晰。
- **按键处理优化完成**：
  - b0 合并/去重：尚未出队的 b0 事件合并；事件出队后 pending 清除，后续按键仍可触发新的重扫
  - b1 提前响应：窗口等待中检测到 b1 立即处理，扫描期间按 b1 立即退出并切档
  - 修复中断被永久关闭的 bug：避免系统卡死
  - 修复 b1 双重切档：B1 事件只被消费一次
- **非阻塞状态机改造完成**：
  - `Measure_Service()` 改为 IDLE/SWEEPING/SWITCHING/MEASURING 四状态互斥状态机
  - ADC 窗口等待、频率扫描、切档全部非阻塞，主循环单次迭代 < 5 ms
  - 按键响应时间从最长 5 秒降至 < 10 ms
  - 运行期不再使用 `FreqScan_Select()`，统一使用 `FreqScanStep()` 状态机
  - `Relay_SetAsync()` / `Relay_NextAsync()` 非阻塞切档接口
  - 自动重扫机制保留（连续失败 3 次触发）

待上板：

- USART3 921600 日志（T1）、与串口屏共存（T2）、速率/丢行（T3/T4）、中断影响（T5）、误码（T6）、回归（T7）。
- 继电器上电默认（R1）：PE3/PE4/PE6 = 0 V / 3.3 V / 0 V（K1 断、K2 合、K3 断）；K2 触点通断约 1.5 kΩ（R2）。
- 上电默认档 `R_eff = 1500 Ω`（R3）、1 kHz 已知 DUT 的 |Y| ≈ 1 mS（R4）、30 s 观察无自动切档（R5）、断电/上电 10 次重复性（R6）。
- b0/b1/b2 按键协议（编号 B，与 USART3 的 T、继电器组的 R 区分）：B1 b0 单击 → 强制重扫，档位与 `f:` 不变；B2 b1 单击 → 切一档（1.5k→15k→150→1.5k 循环），`t10` 立即变 `R:15k`，`f:` 不变；B3 b0 连续两次（间隔 >100 ms）→ 两次重扫，档位不变；B4 b1 连续两次 → 连续切两档。
- 自动量程（编号 C）：C1 b2 单击 → `t10` 变 `R:1.5k A`，再按一次恢复；C2 1 kΩ DUT → 停在 1.5 kΩ；C3 10 kΩ DUT（0.1 mS）→ 自动切 15 kΩ；C4 100 Ω DUT（10 mS）→ 自动切 150 Ω；C5 自动模式下按 b1 → 自动关闭并切一档；C6 断开 DUT → 档位不动、报 E05；C7 复位 → 回 1.5 kΩ 且自动关闭。待上板实测。

## 18. 实施记录

- 继电器三档量程与 b1 单击切档的实施过程记录在 git 历史中；对应 PLAN 文档已完成使命后删除。
