Aliceykr/ImpedScope/PLAN-反馈电阻自动切换.md

# PLAN：反馈电阻程控切换（自动量程）

> **2026-10-22 实机修正**：控制脚 **E2=A0、E3=A1**，四档为 **OA1=15 Ω、OA2=150 Ω、OA3=1.5 kΩ、OA4=15 kΩ**，E#/INH 接 GND。
> 本文下面的旧 150 Ω/1.5 kΩ/15 kΩ/150 kΩ 计算保留为历史方案，实际代码与 README 已按新四档更新。

- 状态：**草案 v0.1，待评审**；其中 M0 决策门未通过前不要投板。
- 日期：2026-10-21
- 适用工程：ImpedScope / 9_30（STM32H750XBH6）
- 关联代码：[USE/measure.c](USE/measure.c)、[USE/measure.h](USE/measure.h)、[USE/screen.c](USE/screen.c)、[USE/screen.h](USE/screen.h)、[Core/Src/main.c](Core/Src/main.c)、[9_30.ioc](9_30.ioc)
- 一句话：用 74HC4052 在 TIA 反馈路径上切换 **150 Ω / 1.5 kΩ / 15 kΩ / 150 kΩ** 四档，固件按 Uo 峰值与削波计数自动选档；**实际激励为 1 Vpp、1.65 V 偏置（Ui 峰值 0.5 V），10 mS 由 150 Ω 档承担（Ron 40%、Uo 1.25 V），其余三档 Ron 占比 ≤6.25%，按任务书 0.1–10 mS、10%/5% 可行**。

> **2026-10-21 修正**：信号源确认为 **1 Vpp、1.65 V 偏置**，即 Ui 峰值 **0.5 V**（此前按 1 V 峰值推导）。
> 四档最终定为 **150 Ω / 1.5 kΩ / 15 kΩ / 150 kΩ**；10 mS 由 150 Ω 档承担（R_eff=250 Ω，Uo=1.25 V，Ron 40%）。
> 本文档 §4.2–§4.4 中按 1 V/0.35 V 推导的数字已被 **§4.5** 取代；代码已按新值实现。

---

## 0. 结论摘要

1. **方案可行**，拓扑是 TIA 多量程的标准做法；R_on 只带来可标定的增益误差（1.5 k/15 k/150 k 档 Ron 占比 ≤6.25%，150 Ω 档 40%），不改变测量原理。
2. **ADC 不会被烧**：运放是 3.3 V 单电源轨到轨，输出最高约 3.3 V，不超过 VDDA；最坏情况是削顶（现有 E19/E20 可检出）。前提是运放与 VDDA 共用同一 3.3 V 轨、且上电时序不出现“运放先上电”。
3. **按实际源 1 Vpp（Ui_pk=0.5 V）和任务书 0.1–10 mS、10%/5% 评估，4052 可行**（详见 4.5 节）：
   - 10 mS 时 DUT 电流 5 mA，在 4052 的 ±25 mA 以内；50 mS 才到 25 mA 上限；
   - 四档取 150 Ω/1.5 k/15 k/150 k：10 mS 由 150 Ω 档承担（Ron 40%，Uo 1.25 V），其余三档 Ron 占比 6.25%/0.66%/0.067%；
   - 150 Ω 档的 Ron 占比是唯一精度风险，标定后温漂约 2%/10 °C，仍在 10% 内；实测 Ron >150 Ω 时余量会变小。
4. 因此 M0 决策门重点改为：**实测 Ron（决定 150 Ω 档余量）/ 10 mS 电流（5 mA）/ 控制引脚可用性**；固件与 PCB 设计按可替换开关抽象，决策后只改 BOM 和参数表。
5. 固件改动集中在 `USE/measure.c`、`Core/Src/main.c`、`USE/screen.c`；**不改** DFT、ADC 采样时序、双 ADC 同步和串口屏协议。

---

## 1. 目标与非目标

### 1.1 目标

- 在 100 Hz–10 kHz、Ui 峰值约 1 V 的条件下，用 4 档反馈电阻覆盖尽量宽的 DUT 导纳范围。
- 上电自动选档；运行中信号变化时自动重选，带滞回，不来回跳。
- 换档后丢弃无效窗口，不把切换瞬态算进结果。
- 串口屏显示当前档位；档位异常有独立错误码。
- 每档可标定，标定值可写入固件常量。

### 1.2 非目标（本次不做）

- 不扩展频点、不改单频 DFT 算法、不改 300 kHz 采样率与 100 周期窗口。
- 不做 ADC 前级 PGA/缓冲；不改双 ADC 同步架构。
- 不做温度补偿闭环（只做误差预算与标定，必要时降档）。
- 不做上位机自动标定工具（先用手工流程）。

---

## 2. 已确认的输入

| 项目 | 取值 | 来源/备注 |
|---|---|---|
| MCU | STM32H750XBH6，TFBGA240 | [9_30.ioc](9_30.ioc) |
| ADC | 16 位、单端 0–3.3 V、VREF+=VDDA=3.3 V | [USE/measure.h](USE/measure.h) |
| 采样 | 300 kHz，双 ADC 同步，1.5 cycle 采样时间 | [Core/Src/adc.c](Core/Src/adc.c) |
| 测量频率 | 100/300/1k/3k/10k Hz 自动扫描 | [Core/Src/main.c](Core/Src/main.c) |
| 运放 | **3.3 V 单电源、轨到轨** | 用户确认（型号待补） |
| 激励 | 外部信号源，**1 Vpp、1.65 V 偏置**（Ui 峰值 0.5 V） | 用户确认 |
| 反馈电阻 | **150 Ω / 1.5 kΩ / 15 kΩ / 150 kΩ**（外部 Rf，原工程为 1.5 kΩ） | 用户确认；按 1 Vpp 源重新推导 |
| 开关 | **74HC4052**，3.3 V 供电 | 用户确认 |
| DUT 导纳范围 | **0.1–10 mS**（任务书 a/b 条）；50 mS 仅作超范围鲁棒性 | 用户提供的任务书截图 |
| 精度指标 | Re[Y]、Im[Y]、\|Y\| 误差 ≤10%，φY 误差 ≤5% | 任务书 a–d 条 |
| 控制引脚 | 由本计划选定，需与实际引出焊盘核对 | 用户授权 |

---

## 3. 硬件方案

### 3.1 拓扑

开关放在 TIA 反馈路径的**输出侧**：4052 公共端接运放输出 `Uo`，四个掷端各接一只反馈电阻，四只电阻的另一端共接运放反相端（虚地）。这也和你手绘图一致。

```text
   运放输出 Uo（0–3.3 V，中心 1.65 V）
        │
    X（COM，4052 公共端）
        │
   ┌────┴────┬─────────┬─────────┐
   │         │         │         │
  X0        X1        X2        X3
   │         │         │         │
 R1 150Ω   R2 1.5kΩ  R3 15kΩ   R4 150kΩ
   │         │         │         │
   └────┬────┴────┬────┴────┬────┘
        │
   运放反相端（虚地 1.65 V）
```

- 选通通道的开关压降只有 `I·Ron`，小电流档在 mV 级，Ron 近似恒定；150 Ω 档（10 mS）Ron 占 40%，见 4.5 节。
- **输出侧的好处**：开关公共端是低阻输出，切换时的电荷注入被运放输出吸收，不会直接打进虚地；选通通道的 `C_on` 也不叠加到 TIA 的输入电容上。
- 未选通道的掷端经各自的 R 停在虚地电位，其 `C_off` 从输出跨到虚地，仍并联在反馈两端，相当于几 pF 的 Cf；本工程工作档 R_max = 15 kΩ，该极点约 700 kHz；150 kΩ 备用档极点约 70 kHz，但它不在 0.1–10 mS 内。

### 3.2 74HC4052 接法

| 引脚 | 名称 | 接法 | 说明 |
|---|---|---|---|
| 16 | VCC | 3.3 V | 与运放、VDDA 同轨；100 nF + 1 µF 就近去耦 |
| 8 | GND | GND | 模拟地，单点回运放地 |
| 7 | VEE | GND | 单电源时必须接 GND |
| 6 | INH | GND | 常使能 |
| 10 | A | PE2（默认） | 档位选择低位；100 kΩ 下拉 |
| 9 | B | PE3（默认） | 档位选择高位；100 kΩ 下拉 |
| 15 | X（COM） | 运放输出 `Uo` | 低阻节点，走线尽量短 |
| 12/13/14/11 | X0/X1/X2/X3 | R1/R2/R3/R4 的一端 | X0=150 Ω，X1=1.5 kΩ，X2=15 kΩ，X3=150 kΩ；四只电阻另一端共接虚地 |
| 3/1/5/2/4 | Y/Y0..Y3 | GND | 另一半不用，全部接地，避免浮空 |

- 档位编码：`A,B = 00/01/10/11` → X0/X1/X2/X3。
- 上电默认：A/B 下拉 = 00 = 150 Ω（最小增益，Uo 最低，最安全）。
- 4052 是先断后合，切换瞬间环路断开约几十 ns；按压摆率 10 V/µs 估算，50 ns 约 0.5 V，仍低于 3.3 V，但电荷注入的瞬态不可忽略，所以换档后一律丢窗并等待 10 ms（见 5.4 节）。

### 3.3 控制引脚

优先选**复用功能少、非 ADC 输入**的引脚，避免数字跳变耦合到模拟节点：

| 优先级 | A | B | 说明 |
|---|---|---|---|
| 首选 | PE2 | PE3 | 仅 FMC/SAI 复用，本工程未用；非 ADC |
| 备选 1 | PD8 | PD9 | USART3，未用；非 ADC |
| 备选 2 | PB0 | PB1 | 可用，但为 ADC 输入脚，模拟耦合略差 |

**这条需要你核对板上实际引出的焊盘**：TFBGA240 空闲脚很多，但只有引到排针/测试点的才能用。若三个方案都引不出来，告诉我可用焊盘，我改表。

### 3.4 无源件与布局

- 每档反馈电阻用 0.1% 薄膜电阻；150 Ω 档按 10 mS/5 mA 约 4 mW，50 mS 超范围时约 67 mW，统一选 1/4 W 留余量。
- 反馈两端并一只 **Cf = 4.7–10 pF**（C0G），位置靠近运放，用于大电阻档稳定；工作档 R_max 为 15 kΩ，Cf 主要起相位/噪声整形作用，具体值在 M2 用阶跃响应确认。
- 四只电阻的**公共节点（虚地）**走线尽量短，周围铺地保护；4052 到运放输出的走线也尽量短；A/B 数字线远离虚地节点，不要从反馈电阻下方穿过。
- 四只电阻靠近 4052 与运放，避免长走线引入寄生电容。
- 模拟地与数字地单点连接，连接点放在运放/ADC 地附近。

### 3.5 ADC 安全

**结论：不会烧。** 依据：

- 运放 3.3 V 单电源轨到轨，输出上限约 3.3 V，等于 VDDA；ADC 模拟脚绝对最大为 `VSSA−0.3 V ~ VDDA+0.3 V`，不会超。
- 4052 由 3.3 V 供电，信号 0–3.3 V，开关本身也不会被超压。
- 换档瞬间即使输出撞轨，也只是到 3.3 V，属于削顶而非过压。

**仍需做的三件事：**

1. **同一 3.3 V 轨**：运放、4052、VDDA 共用一路 3.3 V；若运放用独立 LDO，必须保证其上电不早于 VDDA，否则电流会经 ADC 的 ESD 二极管倒灌。
2. **可选保护位**：在 PA1_C 前预留 100 Ω + BAT54S 到 VDDA/GND 的封装（默认不贴）。100 Ω 与 ADC 输入电容约 1.4 ns 时间常数，1.5 cycle（40 ns）下约 28τ，16 位建立足够；贴上后需实测确认无增益误差。
3. **禁止**把运放换成 5 V 或双电源；若将来要换，必须先加钳位并复核 1.5 cycle 采样。

> 参考：STM32H750XB 数据手册 Absolute maximum ratings（模拟脚电压、注入电流 ±5 mA）。具体数值以你手上修订版为准。

---

## 4. 量程与误差预算（按任务书 0.1–10 mS / 10% / 5%）

> **修正（2026-10-21）**：实际源为 1 Vpp、1.65 V 偏置 → Ui 峰值 **0.5 V**。
> 最终四档为 **150 Ω / 1.5 kΩ / 15 kΩ / 150 kΩ**（见 4.5）；4.2–4.4 是早期按 1 V 峰值的推导，保留作对照。

### 4.1 公式与指标

```text
I       = Ui · Y                 （与反馈电阻无关）
Uo      = -I · R_eff             （R_eff = R + Ron + 走线电阻）
|Y|     = Uo / (Ui · R_eff)
```

- **指标**：Re[Y]、Im[Y]、|Y| 测量范围 0.1–10 mS，误差绝对值 ≤ 理论值 10%；φY 范围 ±90°，误差 ≤ 5%。
- 可用输出摆幅：3.3 V 轨、偏置 1.65 V、留 0.15 V 余量 → 峰值 **0.15–1.5 V**。
- 因为指标是 10%，且有 100 周期 DFT 的 `sqrt(N)≈173` 处理增益，Uo 不需要做到半满量程；0.15 V 只是保守的选档下限，10 mV 量级仍能测。
- 换档判据允许带：**0.15–1.5 V**（10 倍），与 10 倍电阻间距匹配。

### 4.2 4052 下的实际覆盖（Ron = 100 Ω 估算，需实测）

**Ui = 1 V：**

| 档 | R | R_eff | Uo@0.1 mS | Uo@1 mS | Uo@10 mS | 覆盖 \|Y\|（0.15–1.5 V） | Ron 占比 |
|---|---|---|---|---|---|---|---|
| 0 | 27 Ω | 127 Ω | 12.7 mV | 127 mV | 1.27 V | 1.18–11.8 mS | **79%** |
| 1 | 270 Ω | 370 Ω | 37 mV | 370 mV | 3.7 V（削顶） | 0.41–4.05 mS | 27% |
| 2 | 2.7 kΩ | 2.8 kΩ | 280 mV | 2.8 V（削顶） | — | 53.6–536 µS | 3.7% |
| 3 | 27 kΩ | 27.1 kΩ | 2.71 V（削顶） | — | — | 5.5–55.4 µS | 0.37% |

**Ui = 0.35 V：**

| 档 | 覆盖 \|Y\|（0.15–1.5 V） | Uo@0.1 mS | Uo@10 mS | 说明 |
|---|---|---|---|---|
| 0 | 3.38–33.8 mS | 4.45 mV | 0.444 V | 0.1–10 mS 不需要 |
| 1 | **1.16–11.6 mS** | 12.95 mV | **1.295 V** | 覆盖 10 mS 端 |
| 2 | **0.153–1.53 mS** | 98 mV | 3.92 V（削顶） | 中段 |
| 3 | **15.8–158 µS** | 0.95 V | — | 覆盖 0.1 mS 端 |

**Ui = 0.35 V 时**：270 Ω / 2.7 k / 27 k 三档连续覆盖约 **16 µS–11.6 mS**，0.1–10 mS 全程在指标内；**27 Ω 档不会被选中**。Ron 占比最高 27%（270 Ω 档），标定后温度/电压变化引入的误差约 1–2%，远小于 10%。

**Ui = 1 V 时**：27 Ω/270 Ω/2.7 k 覆盖 0.1–11.8 mS，但 **4–10 mS 只能靠 27 Ω 档**（270 Ω 档在 4.05 mS 以上削顶），此时 Ron 占 79%，是唯一需要实测确认的档位。

### 4.3 电流预算

| 场景 | DUT 电流 | 结论 |
|---|---|---|
| 10 mS、Ui = 1 V（任务书上限） | **10 mA** | 在 4052 约 ±25 mA 以内 |
| 10 mS、Ui = 0.35 V | 3.5 mA | 更宽松 |
| 50 mS、Ui = 1 V（超范围） | 50 mA | 超过 4052，由 E21 拦截 |

**注意：电流与选哪一档无关。** 换档只改变 Uo = I·R_eff，不改变流过 DUT 和开关的电流。任务书上限 10 mS 对应 10 mA，4052 够用；只有超范围的 50 mS 才会超。

### 4.4 结论

- 按 10% 指标，4052 的 Ron 误差（27 Ω 档 370%、270 Ω 档 37%）可以逐档标定消除到 10% 以内；270 Ω/2.7 k/27 k 的温漂远小于 10%。
- 唯一风险是 27 Ω 档：Ui=1 V 时承担 4–10 mS，Ron 占 79%，需把 Ron 的电压/温度变化控制在约 12% 以内才能守住 10%。
- 最省事的做法：**Ui 设到约 0.35 V**，让 270 Ω 档覆盖 10 mS；27 Ω 档自然不再被选中，4052 不需要换。
- 50 mS 超出任务书，不承诺精度；用 E21 报“量程不足”，避免静默给出错数。

### 4.5 按实际源 1 Vpp（Ui_pk = 0.5 V）的最终取值

| 档 | R | R_eff | Ron 占比 | 覆盖 \|Y\|（0.15–1.5 V） | 10 mS 时 Uo |
|---|---|---|---|---|---|
| 0 | 150 Ω | 250 Ω | 40% | 1.2–12 mS | **1.25 V** |
| 1 | 1.5 kΩ | 1.6 kΩ | 6.25% | 0.188–1.88 mS | 削顶 |
| 2 | 15 kΩ | 15.1 kΩ | 0.66% | 18.8–188 µS | — |
| 3 | 150 kΩ | 150.1 kΩ | 0.067% | 1.88–18.8 µS | — |

- 10 mS：I = 5 mA，150 Ω 档 Uo = 1.25 V（17% 余量），Ron 40%；标定后温漂约 2%/10 °C，仍在 10% 内。
- 0.1 mS：15 kΩ 档 Uo = 0.755 V，Ron 0.66%，精度余量很大。
- 150 kΩ 只用于低于 18.8 µS，超出任务书下限，作备用；它 10 kHz 的 C_off 相移约 8°，不影响 0.1–10 mS。
- **为什么不用原来的 27/270/2.7k/27k**：0.5 V 峰值下 270 Ω 档在 10 mS 到 1.85 V 会削顶，算法会退回 27 Ω 档（Ron 79%），上段精度不够；27 Ω 也过小。
- 若实测 Ron 明显大于 100 Ω（例如 150 Ω），150 Ω 档在 10 mS 会接近 1.5 V，需要换低 Ron 开关或降低源幅度。

---

## 5. 自动换档策略

### 5.1 总体流程

```text
上电
  → Switch_Init（默认 150 Ω）
  → ADC_Sampler_Init
  → FreqScan_Select（只看 Ui，与 R 无关）
  → 主循环第一个窗口：Switch_Recommend（按 Uo 一跳选档）
  → 主循环：测量 → Switch_Update（必要时换档）→ 显示
```

**关键解耦：** `Ui` 由外部源决定，与反馈电阻无关，所以现有频率扫描（只看 `ui_mag`/`ui_coh`）不受换档影响；量程选择只看 `Uo`。

### 5.2 启动选档（最多 4 个窗口）

1. `Switch_Set(0)`（150 Ω，Uo 最低，最不容易削顶）。
2. 用当前窗口读 `uo_mag`（峰值码值）与 `clip` 计数（当前实现直接用完整 100 周期窗口；5 周期探针是后续优化）。
3. 按以下规则判断：
   - 若削波 → 说明“不超量程”的前提被破坏，报 E21，停在 150 Ω；
   - 若 `uo_mag` 低于 `CIR_OUTPUT_MIN_AMP`（4 码）→ 无法按比例预测，升一档重试；
   - 否则按比例预测各档：`Uo_next = Uo_peak × R_eff[next] / R_eff[k]`，选**预测值不超过 0.88 × 1.5 V（1.32 V）的最大档**（优先大电阻：Ron 占比更小、精度更好）；都不满足则留在当前档。
4. 用选定档跑一个完整窗口（100 周期）复核：不削波、`Uo` 在 0.15–1.5 V；否则 ±1 档微调。
5. 记录该频率下的档位，进入主循环。

> 10 mS 在 Ui_pk = 0.5 V 时由 150 Ω 档覆盖（1.25 V），不会触发 E21；50 mS 超范围场景才由 E21 拦截。

### 5.3 运行时状态机

```c
/* uo_v: Uo 峰值电压(V); clip: 贴边样本数; n: 样本数 */
#define UO_MAX_V   1.50
if (clip * 1000u > n * 10u) {              /* 削波 > 1%：立即降档 */
    if (k > 0) switch_to(k - 1);
    else       report_error(E21);          /* 最小档仍削波：前提被破坏 */
}
else if (uo_v > 0.95 * UO_MAX_V) {         /* > 1.43 V：预防性降档 */
    if (k > 0) switch_to(k - 1);
}
else if (k < 3 && predicted_v(k + 1) <= 0.88 * UO_MAX_V) {
    if (++up_count >= 2) switch_to(k + 1); /* 换大电阻：Ron 占比更小、信噪比更好 */
}
else {
    up_count = 0;                          /* 回到滞回带内，清零计数 */
}
```

- 门限：升档预测上限 **0.88 × 1.5 V = 1.32 V**，降档 **0.95 × 1.5 V = 1.43 V**，滞回约 8%，避免边界抖动。
- 策略是“**选不削顶的最大电阻**”：R 越大，Ron 占比越小、精度越好、信噪比越高；所以只要预测下一档不超 1.32 V 就升档，而不是等信号变小才升。
- **升档要连续 2 个窗口确认**，降档立即执行（安全优先）。
- 换档后 `up_count` 清零，并丢弃当前窗口。
- 预测式：`predicted_v(k+1) = uo_v × R_eff[k+1] / R_eff[k]`。

### 5.4 换档时序

```text
1. Screen_ClearResult()          清显示，避免旧读数
2. Range_Set(k)                  写 A/B，等 10 ms（开关建立 + 运放退出饱和）
3. ADC_Sampler_Restart()         同频强制重开窗（现有 SetFrequency 同频不重开）
4. 丢弃第一窗（不参与判决）      若需要，读掉并忽略
```

- 10 ms 相对 100 ms 窗口（1 kHz）占 10%，可接受；100 Hz 窗口 1 s 时占 1%。
- 若将来用继电器，建立时间改为 5–10 ms，时序不变。

### 5.5 异常处理

| 情况 | 处理 |
|---|---|
| 最小档仍削波 | 报 **E21 RANGE_OUT**，保持 150 Ω，显示 `-`，不输出错误读数 |
| `Uo` 低于 4 码且已到最大档 | 报 E05（现有），保持最大档 |
| `Uo` 相干性低（E15） | 不换档（可能是源没接），保持当前档 |
| 换档后仍削波 | 降一档重试；连续 2 次失败报 E21 |
| 频率切换 | 重新执行 Range_SelectBoot（Y 随频率变） |
| 源幅度变化 | 运行时状态机自然跟随；若变化超过 2 档，重新走启动流程 |

---

## 6. 固件改造

### 6.1 新增模块 [USE/analog_switch.h](USE/analog_switch.h) / [USE/analog_switch.c](USE/analog_switch.c)（已实现）

```c
#define SW_ENABLE        1u      /* 0 = 退回固定 1.5 kΩ */
#define SW_COUNT         4u
#define SW_SETTLE_MS     10u
#define SW_RON_NOMINAL   100.0f
#define SW_UO_UP_V       1.32f   /* 预测下一档 ≤ 此值才升档 */
#define SW_UO_DOWN_V     1.43f   /* 当前 > 此值降档 */
#define SW_CLIP_PERMILLE 10u

void    Switch_Init(void);
uint8_t Switch_Set(uint8_t index);
uint8_t Switch_Get(void);
float   Switch_GetOhm(void);
float   Switch_GetNominalOhm(uint8_t index);
void    Switch_SetCalibratedOhm(uint8_t index, float ohm);
uint8_t Switch_Recommend(float uo_peak_v);
uint8_t Switch_Update(float uo_peak_v, uint32_t clip_count, uint32_t sample_count);
```

- 档位：**150 Ω / 1.5 kΩ / 15 kΩ / 150 kΩ**；默认 R_eff = 标称 + 100 Ω Ron 预估。
- 控制脚：PE2 = A、PE3 = B；改脚只改 `analog_switch.h` 顶部宏，并同步 `.ioc`。
- `Switch_Recommend()` 用于上电/换频后一跳选档；`Switch_Update()` 用于运行时带滞回升降档。

### 6.2 [USE/measure.c](USE/measure.c) / [USE/measure.h](USE/measure.h)（已实现）

- `CIR_FEEDBACK_RESISTOR_OHM` 保留为默认值；新增 `s_r_feedback` 与
  `CircuitID_SetFeedbackResistor()` / `CircuitID_GetFeedbackResistor()`，
  `CircuitID_Compute()` 里三处引用改用它。
- 新增 `ADC_Sampler_Restart()`：同频强制重开窗口（保留频率、步进和窗口长度），
  换档后丢弃切换瞬间的样本。

### 6.3 [Core/Src/main.c](Core/Src/main.c)（已实现）

- `Switch_Init()` + `CircuitID_SetFeedbackResistor(Switch_GetOhm())` 放在
  `CircuitID_Init()` 之后、`ADC_Sampler_Init()` 之前。
- 新增 `Window_UoPeakV()`，由窗口的 `uo_re/uo_im` 算 Uo 基波峰值电压。
- 上电/换频后第一个窗口用 `Switch_Recommend()` 一跳选档；之后每窗调用
  `Switch_Update()`。换档后同步 R、清显示、`ADC_Sampler_Restart()` 并丢弃当前结果。
- b0 强制刷新时把 `range_ready` 清 0，重新选档。

### 6.4 屏幕显示（未实施，后续）

- 本次未改 `screen.c/h`：档位不上屏，E21 未新增；最小档削波仍由现有 E19/E20 报出。
- 后续要显示档位时，复用 `t5` 组合成 `stage:LOOP R:1.5k`，不新增 HMI 控件。
- 新增错误码：

```c
SCREEN_E21_RANGE_OUT = 21u,   /* 最小反馈电阻仍削波/饱和，量程前提被破坏 */
```

- 同时把 `SCREEN_ERROR_CODE_MAX` 从 20u 改为 21u，并同步 README 的错误码表。

- `t0` 仍是频率，`t9` 仍是 H，`t10` 仍是 H 相位；**不新增屏幕控件**，避免改 HMI 工程。

### 6.5 标定表（未实施，后续）

- `s_calib[]` 从一维（频率）扩展为二维 `[RANGE_COUNT][CALIB_COUNT]`，`Calib_Lookup(range, f)` 同步改。
- 每个档位的 `mag_ratio` 与 `phase_deg` 都不同（Ron、C_on/C_off 随档变）。
- 旧的 985 Ω 电阻 / 1500 Ω 反馈标定数据作废，全部重测。

### 6.6 [9_30.ioc](9_30.ioc)（已改）

- 新增 `Mcu.Pin16=PE2`、`Mcu.Pin17=PE3`，`PinsNb=18`；PE2/PE3 为 `GPIO_Output`、推挽、初始低电平，标签 SW_A/SW_B。
- **顺手修正了一处不一致**：`UART4.BaudRate` 由 9600 改为 921600，与 [Core/Src/usart.c](Core/Src/usart.c) 一致；否则 CubeMX 重新生成会把串口屏波特率改回 9600。
- 重新生成后检查：`USE/` 目录仍在、`main.c` USER CODE 区仍调用 `Screen_Init`/`ADC_Sampler_Init`/`Switch_Init`。

### 6.7 构建（已验证）

- `analog_switch.c` 已加入 `MDK-ARM/9_30.uvprojx` 的 `Application/User/USE` 组。
- `bash .ccg-build/build.sh <outdir>`：38 个源文件、0 错误、链接通过（Code≈47.5 KB）。
- 构建脚本在沙箱里要通过 Git Bash 的命名管道；若被拦，按规则对构建命令单独申请权限。

---

## 7. 标定

### 7.1 每档 R_eff 标定

1. 断电，用四位半万用表量每只反馈电阻的实测值（记录，但不作为最终值）。
2. 上电，选到该档，接一只 0.1% 精密电阻 `R_cal`（如 1 kΩ）作为 DUT。
3. 读出 `H = Uo/Ui` 的复数；`R_eff = -H · R_cal`（因为 `H = -R_eff/R_cal`）。
4. 四档重复；写入 `s_range_cal[]`。
5. 150 Ω 档标定后 `R_eff` 会接近 250 Ω；它是 10 mS 档，Ron 占 40%，按 T1 的 Ron 电压/温度变化判断 10% 是否守住。

### 7.2 每档 × 每频点 H_thru 标定

1. 把 Ui 与 Uo 短接到同一信号源（直通），DUT 断开。
2. 对 1 kHz、10 kHz（以及 100/300/3k 若启用）逐档测 `H`。
3. `mag_ratio = 1/|H|`，`phase_deg = angle(H)`，填入二维表。
4. 换档会改变 C_off 造成的相位，必须逐档做，不能复用 1.5 kΩ 的旧表。

### 7.3 验收

- 每档 `R_eff` 标定残差 ≤ 2%（相对已知 DUT 反算），保证最终 \|Y\| 误差 ≤ 10%。
- 直通后 `H` 修正到 0 dB ± 0.1 dB、0° ± 1°（1 kHz），保证 φY 误差 ≤ 5%。
- 最终验收按任务书：Re/Im/\|Y\| ≤ 10%，φY ≤ 5%（1 kHz、10 kHz 各测）。

---

## 8. 测试计划

| 编号 | 测试 | 方法 | 通过标准 |
|---|---|---|---|
| T1 | Ron 实测 | 恒流经 X0，在 0.1/0.5/1 V 三个工作点量压降；25 °C 与预热 30 min 各一次 | 记录 Ron 的电压/温度变化，供 M0 决策 |
| T2 | R_eff 标定 | 7.1 节 | 见 7.3 |
| T3 | 精度扫描 | 100 Ω/1 k/10 k（对应 10/1/0.1 mS）精密电阻，1 kHz 与 10 kHz | Re/Im/\|Y\| ≤10%，φY ≤5% |
| T4 | 换档边界 | 可变电阻/多只 DUT 在档位交界来回 | 不振荡；换档 ≤ 50 ms；无错误读数 |
| T5 | 安全 | 示波器测 Uo 在上电、换档、最大 \|Y\|、拔插 DUT 四种瞬态 | 峰值 ≤ 3.3 V + 0.1 V；无过冲到 3.6 V |
| T6 | 电流 | 串入电流表测源输出与运放输出，\|Y\|=10 mS | 峰值 ≤5 mA，不超过开关/运放/源额定；50 mS 仅做鲁棒性观察 |
| T7 | 回归 | 频率扫描、屏幕 t0–t10、20 个错误码 | 与改造前一致（除新增档位显示） |

---

## 9. 风险与决策门

### 9.1 M0 决策门（投板前必须通过）

| # | 决策项 | 数据来源 | 选项 |
|---|---|---|---|
| D1 | 150 Ω 档 Ron 40% 是否可接受 | T1 + 10 mS 实测 | A 温漂/电压变化 ≤10% → 保留 4052（推荐）；B 超 10% → 换低 Ron 开关 |
| D2 | 实测 Ron 是否接近 100 Ω | T1 | A ≤120 Ω → 10 mS 余量够；B >150 Ω → 150 Ω 档到 1.5 V，需降源幅度或换开关 |
| D3 | 运放 5 mA 输出能力（150 Ω 档） | 型号 datasheet | A 够；B 换运放；C 加缓冲 |
| D4 | 控制引脚可用性 | 板子实物 | 三个候选方案择一 |

**未通过 D1/D2 前，不投板、不冻结 BOM。**

### 9.2 风险清单

| 风险 | 影响 | 等级 | 缓解 |
|---|---|---|---|
| 4052 Ron ≈ 100 Ω | 150 Ω 档 Ron 占 40%，10 mS 时精度风险 | **中** | T1 实测 Ron 变化；必要时换低 Ron 开关 |
| 5 mA 电流 | 在 4052 ±25 mA 内，风险低 | 低 | 常规去耦；50 mS 超范围由 E21 拦截 |
| 运放输出电流不足 | 150 Ω 档 5 mA 时可能饱和 | 中 | M0-D3；查 datasheet/实测 |
| Ron 温漂 | 低档读数漂移 | 中 | 低档继电器；温度系数预算 |
| 开关电荷注入 | 换档瞬态污染窗口 | 低 | 丢首窗 + 10 ms 等待 |
| C_off 相位 | 15 k 档相位误差 | 低 | Cf + 逐档标定；150 k 档仅备用 |
| `.ioc` UART 9600 | 重生成后屏幕乱码 | 中 | 前置修复为 921600 |
| CubeMX 覆盖用户代码 | 功能丢失 | 低 | 只改 USER CODE 区；生成后走第 9 节检查表 |
| HMI 无档位控件 | 档位显示不出 | 低 | 复用 t5 字符串，不改控件 |
| 标定工作量大 | 4 档 × 5 频点 | 中 | 先只标 1 kHz/10 kHz；其余用就近值 |

---

## 10. 任务拆分

| 阶段 | 内容 | 产出 | 预估 |
|---|---|---|---|
| M0 | 测 Ron（0.1/0.5/1 V、25 °C/预热）、测 10 mS 电流（5 mA）、核对引脚 | 决策记录（D1–D4） | 0.5 天 |
| M1 | 原理图/PCB：4052、四电阻、Cf、A/B 下拉、去耦、保护位 | 改板图 + BOM | 1 天 |
| M2 | 固件：Range API、启动选档、运行时状态机、屏幕、E21 | 可编译固件 | 1–2 天 |
| M3 | 标定：R_eff、逐档 H_thru | 标定表 | 1 天 |
| M4 | 测试 T1–T7 + 文档更新 | 测试报告 + README | 1 天 |

---

## 11. 需要你确认/提供的输入

1. **运放型号与输出电流能力**（以及是否确实 3.3 V 单电源、轨到轨）。
2. **板上实际引出的空闲焊盘**（PE2/PE3、PD8/PD9、PB0/PB1 是否有测试点/排针）。
3. 激励已确认：**1 Vpp、1.65 V 偏置**（Ui_pk = 0.5 V），不再需要选 Ui。
4. 精度指标已由任务书确定（Re/Im/\|Y\| ≤10%，φY ≤5%），无需再定。
5. 外部信号源在 5 mA 峰值下的驱动能力（任务书上限 10 mS）。
6. 串口屏 `t5` 能否显示 `stage:LOOP R:1.5k` 这种较长字符串（不能的话改用两位编码）。

---

## 12. 文件改动地图（实施时对照）

| 文件 | 改动 | 状态 |
|---|---|---|
| [USE/analog_switch.h](USE/analog_switch.h) | 4 档 API、Ron/门限/引脚宏 | 已新增 |
| [USE/analog_switch.c](USE/analog_switch.c) | GPIO、档位表、Recommend/Update、标定入口 | 已新增 |
| [USE/measure.h](USE/measure.h) | `CircuitID_SetFeedbackResistor`、`ADC_Sampler_Restart` 声明 | 已改 |
| [USE/measure.c](USE/measure.c) | `s_r_feedback`、三处引用、Restart | 已改 |
| [Core/Src/main.c](Core/Src/main.c) | Switch_Init、Window_UoPeakV、Recommend/Update、b0 重扫 | 已改 |
| [MDK-ARM/9_30.uvprojx](MDK-ARM/9_30.uvprojx) | 加入 `analog_switch.c` | 已改 |
| [9_30.ioc](9_30.ioc) | PE2/PE3 GPIO、UART4 921600 | 已改 |
| [USE/screen.c](USE/screen.c) / [USE/screen.h](USE/screen.h) | 档位显示、E21 | 未实施 |
| [README.md](README.md) | 自动量程章节、错误码/接口更新 | 未实施 |

---

## 附录 A：为什么换档判据用 Uo 而不是 Ui

```text
Ui 由外部源决定，与 R 无关；Uo = Ui · Y · R 随 R 线性缩放。
所以：
  选频率 → 看 Ui 的幅值与相干性（现有逻辑，不受 R 影响）
  选量程 → 看 Uo 的峰值与削波（R 的直接结果）
两者可以解耦，先选频再选档，互不干扰。
```

## 附录 B：4052 档位编码

| A | B | 选通 | 档位 |
|---|---|---|---|
| 0 | 0 | X0 | 150 Ω |
| 1 | 0 | X1 | 1.5 kΩ |
| 0 | 1 | X2 | 15 kΩ |
| 1 | 1 | X3 | 150 kΩ |

## 附录 C：待决策项的默认假设（未确认前按此写代码）

- 开关：74HC4052 @ 3.3 V，Ron 按 100 Ω 预留误差预算。
- 档位：150/1.5k/15k/150k，Ron 用标定值补偿。
- 控制脚：PE2/PE3，编码见附录 B。
- 默认档：150 Ω。
- 激励：1 Vpp、1.65 V 偏置（Ui_pk = 0.5 V）。
- 精度指标：Re/Im/\|Y\| ≤10%，φY ≤5%（任务书）。
- 若 M0 决定换开关，只改 `s_range_cal[]`、BOM 和引脚表，固件结构不变。
