Aliceykr/ImpedScope/设计报告.md

# STM32H750 单频导纳测量系统设计报告

- 版本：2026-10-18
- 代码基线：`697878b`（自动识别五档频率并支持强制刷新）
- 目标芯片：STM32H750XBH6
- 开发环境：Keil MDK 5.43a + ArmClang 6.24

---

## 1. 项目概述

本系统用于测量无源单端口网络在单一频率下的导纳，并显示：

- 导纳实部 `G = Re[Y]`
- 导纳虚部 `B = Im[Y]`
- 导纳模值 `|Y|`
- 导纳相位 `φY`
- 传递函数 `H = Uo/Ui` 的幅值 `H(dB)` 与相位 `A(°)`
- Ui、Uo 的交流有效值和相干性

激励由外部信号源提供，信号源只会在以下五档之间切换：

```text
100 Hz / 300 Hz / 1 kHz / 3 kHz / 10 kHz
```

固件不驱动 DDS，只负责采样、DFT、标定、自动识别频率和串口屏显示。

---

## 2. 硬件与信号链

### 2.1 引脚

| 信号 | 引脚 | ADC 通道 | 说明 |
|---|---|---|---|
| Ui | PA0_C | ADC1_INP0 | DUT 激励电压 |
| Uo | PA1_C | ADC2_INP1 | 跨阻放大器输出 |

DUT 的冷端接运放虚地，而不是接运放输出。

### 2.2 模拟链路

```text
外部信号源 → Ui 节点 → DUT → 运放虚地
                              │
                              └── 跨阻放大器 Rf=1500 Ω → Uo
```

基本关系：

```text
I = Ui · Y
Uo = -I · Rf = -Ui · Y · Rf
H = Uo / Ui = -Y · Rf
Y = -H / Rf
Z = -Rf / H
```

因此 `Rf` 的准确值直接进入 `Y`。当前固件常量：

```text
CIR_FEEDBACK_RESISTOR_OHM = 1500.0f
```

### 2.3 双 ADC 同步采样

- TIM6 以 300 kHz 触发 ADC；
- ADC1（主）和 ADC2（从）工作在双 ADC 规则同步模式；
- 每个 32 位 CDR 字包含一对同一时刻的 Ui/Uo；
- 由 ADC1 的 DMA 搬运到 `adc_pair_buf`；
- 采样时间使用 `ADC_SAMPLETIME_1CYCLE_5`。

> 曾试验 64.5 周期采样时间，但会触发 E04，已回退。当前版本保持 1.5 周期。

---

## 3. 单频 DFT 与窗口

### 3.1 窗口长度

每个测量窗口取 100 个信号周期：

```text
N = round(100 × Fs / f)
Fs = 300 kHz
```

对应窗口时间：

| 频率 | 窗口点数 | 时间 |
|---|---:|---:|
| 100 Hz | 300000 | 1 s |
| 300 Hz | 100000 | 333 ms |
| 1 kHz | 30000 | 100 ms |
| 3 kHz | 10000 | 33.3 ms |
| 10 kHz | 3000 | 10 ms |

窗口点数上限 400000，下限 256。100 Hz 的 1 s 窗口是主循环超时取 1500 ms 的原因。

### 3.2 DFT

对每个窗口去直流后计算单频相量：

```text
S = Σ (x[n] - mean) · e^(-j·2π·f·n/Fs)
```

幅值：

```text
|U| = 2·|S| / N
```

两路使用相同窗口和相同点数，因此：

```text
H = Uo · conj(Ui) / |Ui|²
```

### 3.3 相干性

```text
kappa = |U| / (√2 · Uac_rms)
```

纯单频时接近 1；噪声/失真时下降。Ui、Uo 分别检查，低相干会报 E14/E15。

---

## 4. 标定

### 4.1 修正关系

当前标定采用单点复数修正：

```text
H_corrected = H_meas · mag_ratio · e^(-j·phase_deg)
```

其中：

```text
mag_ratio = |H_true| / |H_meas|
phase_deg = angle(H_meas) - angle(H_true)
```

实现位于 `USE/measure.c` 的 `Calib_Apply()`。

### 4.2 当前标定表

```c
static const Calib_Point_t s_calib[] = {
    {  1000.0f, 1.002f, -1.19f },
    { 10000.0f, 1.034f, -12.00f },
};
```

标定基准是同一只 **985 Ω 纯电阻**，`Rf=1500 Ω`：

- 1 kHz：985 Ω 理论 `|H|=1.52284`，理论相位 0°；
- 10 kHz：同样 DUT，固定相位误差约 -12°，增益比约 1.034。

`Calib_Lookup()` 采用就近取值，不做插值：

- 1 kHz 用 1 kHz 点；
- 10 kHz 用 10 kHz 点；
- 100/300/3k 会使用最近的 1 kHz 点。

> 这是当前系统的已知限制：标定点不足，不能保证所有频点都达到 10 kHz 的精度。

### 4.3 标定的边界

标定只能修正“与 DUT 无关的固定通道增益/相位”。

它不能修正：

- 运放削波/非线性；
- 电感/电容的真实 ESR、DCR、介质损耗；
- 源频率偏差；
- 夹具/接线的负载相关相移；
- 单窗口噪声。

因此，纯电阻标定后，不同 DUT 仍可能残留不同的相位误差。

---

## 5. 自动频率识别

### 5.1 需求

外部信号源只会在五档之间切换，固件不再使用按钮选择频率。

### 5.2 扫描算法

`Core/Src/main.c` 中的 `FreqScan_Select()`：

1. 候选顺序：

```text
1 kHz → 10 kHz → 3 kHz → 300 Hz → 100 Hz
```

2. 对每个候选频率调用 `ADC_Sampler_SetFrequency()`，等一个完整窗口；
3. 计算 Ui 的单频幅值 `ui_mag` 和相干性 `ui_coh`；
4. 评分：

```text
score = ui_mag × ui_coh
```

5. 选择 `score` 最大且满足：

```text
ui_mag > CIR_INPUT_MIN_AMP
ui_coh > 0.5
```

的候选；

6. 如果某个候选 `ui_coh > 0.95`，认为已经锁定，提前结束扫描；
7. 五档都不可信时，回退到 1 kHz 并返回 0。

### 5.3 启动与重扫

- 上电初始化后先执行一次 `SCAN`；
- 正常测量时，如果连续 3 个窗口计算失败（E04/E05/E12/E14/E15 等），自动重新扫描；
- 扫描成功后 `stage:LOOP`；
- 扫描失败则回到 1 kHz 并报 E04。

### 5.4 按键

HMI 的 `b0`（原 `freq_change`）现在只作为**强制刷新键**：

```text
按下 → stage:SCAN → 重新扫描五档 → stage:LOOP → 重新测量
```

不再切换频率，也不需要按硬件复位。

`Screen_TakeRefreshKey()` 只返回按键事件，不修改目标频率。

### 5.5 扫描耗时

扫描耗时取决于命中的档位：

- 1 kHz：约 100 ms；
- 10 kHz：约 110 ms；
- 3 kHz：约 150 ms；
- 300 Hz：约 500 ms；
- 100 Hz：约 1.5 s（因为 100 Hz 窗口本身为 1 s）。

---

## 6. 显示与错误系统

### 6.1 显示字段

| 字段 | 内容 |
|---|---|
| `f:` | 当前测量频率（Hz） |
| `t1` | `|Y|`（mS） |
| `t2` | `φY`（°） |
| `t3` | `G`（mS） |
| `t4` | `B`（mS） |
| `t5` | `stage:` 或最近错误码及计数 |
| `t6` | `beat:` 心跳 |
| `t7` | `Ui` 有效值、Ui 相干性 |
| `t8` | `Uo` 有效值、Uo 相干性 |
| `t9` | `H` 幅值（dB） |
| `t10` | `A`：H 相位（°） |

`t9` 原来把 `H(dB)` 和 `A` 放在同一行，HMI 字段宽度不足，A 被截断。现在 A 单独放在 `t10`；频率由 `f:` 显示，`t10` 不再重复频率。

### 6.2 错误恢复

`Screen_ReportError()` 只记录最近错误和计数。之前没有“恢复”路径，导致报过一次 E04/E15 后 `t5` 永远停在错误。

现在：

- 每个新窗口计算前调用 `Screen_ClearError()`；
- 如果本窗口再次异常，`CircuitID_Compute()` 会重新报错；
- 如果本窗口正常，`t5` 回到 `stage:LOOP`；
- 错误计数保留，便于定位。

### 6.3 单窗口判定

`CircuitID_Compute()` 返回 0 的窗口会执行 `Screen_ClearResult()`，即 t0~t4、t9、t10 显示 `"-"`。

因此，一个坏窗口会造成一次显示清空；连续坏窗口才会持续显示错误。这是当前“数值一下好一下不好”的主要代码层原因之一，不是滤波或 DFT 不稳定。

---

## 7. 测试记录

以下为 1 kHz/10 kHz 台面测试的代表性数据，用于说明系统行为，不作为正式计量结果。

### 7.1 985 Ω 纯电阻，10 kHz

标定后：

```text
P = 0.06°
B = 0.001 mS
G = 1.016 mS
Y = 1.016 mS
H = 3.66 dB
```

理论：

```text
G = 1/985 = 1.015 mS
P = 0°
H = 20log10(1500/985) = 3.65 dB
```

说明 10 kHz 固定相位标定方向正确。

### 7.2 1 kΩ ∥ 100 nF，10 kHz

测量时降低 Ui，避免 Uo 进入非线性：

```text
Ui = 0.0580 V
Uo = 0.5313 V
P = 80.71°
B = 6.299 mS
G = 1.030 mS
Y = 6.382 mS
H = 19.62 dB
```

理论（理想 1 kΩ ∥ 100 nF）：

```text
G = 1.000 mS
B = 6.283 mS
Y = 6.362 mS
P = 80.96°
H = 19.59 dB
```

误差约：

```text
G: +3.0%
B: +0.25%
|Y|: +0.31%
P: -0.25°
```

### 7.3 1 kΩ ∥ 10 mH（DCR≈35 Ω），10 kHz

实际电感不是理想 10 mH，而是 10 mH 串联约 35 Ω：

```text
P = -55.07°
B = -1.583 mS
G = 1.105 mS
Y = 1.930 mS
H = 9.24 dB
```

按 10 mH + 35 Ω 理论：

```text
G ≈ 1.088 mS
B ≈ -1.587 mS
Y ≈ 1.925 mS
P ≈ -55.6°
H ≈ 9.21 dB
```

误差约 1%～3%，说明电感的 DCR 必须进入理论模型；按理想 10 mH 计算会把 G 的误差放大。

### 7.4 30 kΩ ∥ 10 nF，1 kHz

```text
G = 0.033 mS
B = 0.059 mS
Y = 0.068 mS
P = 60.78°
H = -19.82 dB
```

由 B 反推：

```text
C ≈ 9.4 nF
```

更接近电容实际值，而不是测量错误。

---

## 8. 已知限制

1. **仅支持五档固定频率**  
   任意频率需要过零检测或 TIM 输入捕获，并处理非整数周期 DFT。

2. **自动扫描有启动延迟**  
   100 Hz 档最坏约 1.5 s；期间屏幕显示 `SCAN`。

3. **源频必须准确**  
   固件不测源频，只按标称频率做 DFT；源频偏差会直接变成幅相误差。

4. **单窗口判定会造成显示闪烁**  
   一个坏窗口会清空结果；尚未加入中值/保持/平均。

5. **标定点只有 1 kHz 和 10 kHz**  
   100/300/3k 使用就近的 1 kHz 修正，精度不能保证。

6. **DUT 相关相位仍可能存在**  
   纯电阻标定不能消除电感/电容 ESR、DCR、夹具和负载相关相移。

7. **高阻/大幅值测量容易 E15/E20**  
   10 kHz 高阻网络 Uo 可能接近电源轨，需降低 Ui；电感网络要按实际 DCR 建模。

8. **HMI 按钮文字仍是 `freq_change`**  
   功能已经改为强制刷新；界面文字可在 HMI 工程中改，不影响固件。

---

## 9. 构建与烧录

### 9.1 Keil

```text
Project: MDK-ARM/9_30.uvprojx
Target:  9_30
Toolchain: ArmClang 6.24
```

当前构建：

```text
0 Error(s), 0 Warning(s)
Code=50474
RO-data=1854
RW-data=20
ZI-data=3724
```

### 9.2 输出

```text
MDK-ARM/9_30/9_30.hex
```

烧录后：

- 上电自动识别五档；
- `t10` 显示 H 相位；
- `freq_change` 按钮作为强制刷新；
- 源切换后自动重扫；
- 错误恢复后 `t5` 回到 `LOOP`。

---

## 10. 主要文件

| 文件 | 作用 |
|---|---|
| `Core/Src/main.c` | 主循环、自动五档扫描、强制刷新、重扫状态机 |
| `Core/Src/adc.c` | ADC1/ADC2 初始化、双 ADC 同步、采样时间 |
| `USE/measure.c` | DFT、H/Y/Z、标定表、窗口采样 |
| `USE/measure.h` | 测量参数、窗口结构、错误码/配置 |
| `USE/screen.c` | HMI 串口协议、按键、t0~t10、错误显示 |
| `USE/screen.h` | 屏幕接口 |
| `README.md` | 使用说明与已知限制 |

---

## 11. 后续改进建议

1. 为 100/300/3k 增加标定点，或将相位误差建模为随频率变化的延迟；
2. 在显示层加入 3 点中值/滑动平均，或坏窗口保持，减少单窗口闪烁；
3. 若需要任意频率，使用比较器 + TIM 输入捕获，而不是 ADC 过零；
4. 需要通用精度时，引入 Open/Short/Load 一端口三项误差模型；
5. 高阻 DUT 增加输入缓冲，减少 ADC 采样负载；
6. 把 HMI 按钮文字改为“刷新/重测”，并在 README 中同步说明；
7. 对 10 kHz 电感/电容测量给出建议的 Ui 幅度范围，避免 E15/E20。
