Aliceykr/ImpedScope/PLAN-单频点改造.md

# PLAN:改为单频点(1 kHz)

> 目标:把固件从「5 频点循环扫描」改为「只测 1 kHz」。
> 本文档只描述计划,**尚未执行**。确认后再改代码。
>
> 基线:`main` 分支,HEAD = `97aa7a9`(工作区干净,仅有未跟踪的 `.ccg-build/`)

---

## 0. 背景与前提

- 硬件上 **AD9833 已不存在**,SPI 只是保留未删。外部用**独立信号源**提供 1 kHz 正弦激励。
- 因此 `Freq_SourceSet()` → `AD9833_SetFrequency()` 这条路径**实际为空转**(不会返回值,也不会报 E13),
  但代码仍会每轮执行 SPI 写操作。见 §3.4 的处理建议。
- 本次改动**只与频率有关**,不涉及前端电路、幅度、量程。

---

## 1. 必改项(2 处,缺一不可)

### 1.1 频率表 — `USE/measure.c:28-30`

```c
/* 改前 */
static const uint32_t s_freq_plan[FREQ_PLAN_COUNT] = {
    100u, 300u, 1000u, 3000u, 10000u
};

/* 改后 */
static const uint32_t s_freq_plan[FREQ_PLAN_COUNT] = {
    1000u
};
```

### 1.2 频点个数 — `USE/measure.h:33`

```c
/* 改前 */
#define FREQ_PLAN_COUNT   5u
/* 改后 */
#define FREQ_PLAN_COUNT   1u
```

> `main.c:155` 的 `for (k = 0u; k < FREQ_PLAN_COUNT; ++k)` **不需要改**,
> 它会自动退化为「反复测 1 kHz」。

---

## 2. 建议改项(3 处,不影响功能但会误导)

### 2.1 标定表精简 — `USE/measure.c:458-464`

```c
/* 改后 */
static const Calib_Point_t s_calib[] = {
    {  1000.0f, 1.0f, 0.0f },
};
```

**理由:** `Calib_Lookup()` 是**就近取值、不插值**。留 5 个点功能上无害
(1000 Hz 正好命中,且当前全是恒等值),但会让后续做直通标定时误以为要填 5 个频点。

### 2.2 `s_freq_plan` 上方的注释 — `USE/measure.c:23-27`

现状写的是「5 个测量频率,与赛题要求一致。顺序扫描 100 -> 300 -> ...」,
改单频后必须同步改写,否则注释与代码矛盾。

### 2.3 `measure.h` 的窗口校验表 — `USE/measure.h:69-93`

现有一大段注释(**整个校验表**)是为 5 频点写的:

- `:70` 「取 300 kHz 的依据:5 个测量频率 100/300/1000/3000/10000 Hz 之比为 1:3:10:30:100」
- `:83` 「Fs = 300 kHz 时,5 个频率的窗口长度整数周期校验:」+ 5 行表格
- `:90` 「5 行全部落在 [WINDOW_MIN, WINDOW_MAX] 内,无钳位」

**⚠️ 这里有个需要决策的连带问题 —— 见 §4.1。**

---

## 3. 随之而来的**功能性问题**(必须知晓)

### 3.1 ⚠️ 300 kHz 采样率的「选择依据」失效了

**这是最容易被忽略的连带影响。**

`300 kHz` 这个采样率当初是这样选出来的(`measure.h:70-71`):

> 取 300 kHz 的依据:5 个测量频率之比为 1:3:10:30:100,**故 Fs/f 全为整数**

也就是说,**300 kHz 是为了让 5 个频点同时满足整数周期才选的**。

改成单频点后,只需要满足 **1 个**频率的整数周期条件 —— 300 kHz 不再是唯一解,
但**它仍然满足**(300000/1000 = 300,整数)。

**结论:采样率不用改,但注释里的"选它的理由"必须改写**,否则后续维护者会依据错误前提去改。

### 3.2 ⚠️ 窗口长度可以放大,而且**应该**放大

当前 `ADC_SAMPLER_WINDOW_CYCLES = 10`,1 kHz 下窗口 = **3000 点 / 10 ms**。
这个值是为 5 频点设计的(限制在 100 Hz 时窗口不至于过长)。

**单频点下没有这个约束了**,窗口可以按信噪比需要自由加长:

| CYCLES | N (点) | 窗口时长 | √N (相干增益) | κ 噪声底 | 是否超 MAX(400000) |
|---|---|---|---|---|---|
| **10(当前)** | **3000** | **10 ms** | **54.8** | **0.0258** | 否 |
| 20 | 6000 | 20 ms | 77.5 | 0.0183 | 否 |
| 50 | 15000 | 50 ms | 122.5 | 0.0115 | 否 |
| **100** | **30000** | **100 ms** | **173.2** | **0.0082** | 否 |
| 200 | 60000 | 200 ms | 244.9 | 0.0058 | 否 |
| 500 | 150000 | 500 ms | 387.3 | 0.0037 | 否(但贴超时预算) |

**决策项**:是否需要提高 `ADC_SAMPLER_WINDOW_CYCLES`?
- 若保持 **10** → 改动最小,信噪比够用(相干增益 54.8),窗口 10 ms
- 若提到 **100** → 信噪比提升 3.2 倍,窗口 100 ms,主循环 500 ms 超时仍安全
- ⚠️ 上限:窗口时长必须 < 主循环超时 `MEASURE_WAIT_TIMEOUT_MS = 500 ms`(`main.c:46`)

### 3.3 ⚠️ `ADC_Sampler_SetFrequency()` 的同频早退行为会变化

`measure.c:315-319`:

```c
/* 同一频率不重启窗口,避免重复设置时窗口永远完不成。 */
if ((frequency_hz == s_frequency_hz) && (s_target != 0u))
{
    return 1u;      /* 早退,不重置窗口 */
}
```

**5 频点时**:每轮频率都不同 → 每次都进入下面的重置逻辑 → 每轮都重启窗口。

**单频点时**:第 1 轮设过 1000 后,`s_frequency_hz` 恒为 1000,
**第 2 轮起每次都走早退分支**,窗口**不会重启**,而是由 `ADC_Sampler_TryFinish()`
自动连续翻滚(窗口一满就自动开下一个)。

**这实际上是好事**(窗口连续测量,无重启间隙),但需要确认:

- 主循环每轮等一个新的 `s_ready`。窗口 10 ms 一个,主循环节奏远快于此,
  **不会超时**。若把窗口加长到 500 ms(§3.2),则可能撞上 500 ms 超时 → 报 E12。
- **务必让窗口时长明显小于 500 ms**,建议 ≤ 200 ms。

### 3.4 `Freq_SourceSet()` 每轮仍会发 SPI(空转)

`main.c:163` 每轮调用 `Freq_SourceSet(f)`,内部 `measure.c:42` 调 `AD9833_SetFrequency()`。

AD9833 不存在 → SPI 写会超时或返回非 OK → **可能每轮误报 E13**。

**⚠️ 这是改单频点后必须验证的一点。** 三种处理方案:

| 方案 | 做法 | 评价 |
|---|---|---|
| A | 不动(保持现状) | ⚠️ 若 SPI 无响应会持续报 E13,需实测确认 |
| B | 把 `Freq_SourceSet()` 改为空函数 | 最干净,但若将来恢复 AD9833 需改回 |
| C | 屏蔽 `main.c:163` 的调用 | 同样干净,但注释需说明原因 |

**建议:B**(在 `measure.c:32` 的 `Freq_SourceSet()` 内直接 `return`),
理由:调用点(`main.c`)不动,只改实现,接口契约保持。

> 需实测确认:AD9833 不在时,`HAL_SPI_TransmitReceive()` 是返回超时(→ E13)
> 还是立即返回 HAL_OK(→ 不报错)。**取决于 SPI1 的 NSS 状态与 MISO 悬空情况。**

### 3.5 E13 错误码的语义会变得含糊

单频点 + 无 AD9833 后,`SCREEN_E13_AD9833_SPI` 只在"SPI 写失败"时触发,
但这条路径已无实际意义。**建议保留错误码(不删编号),但在 README 中注明当前不再使用。**

---

## 4. 文档改动(README + 控件清单)

### 4.1 README 需改的位置(共 10 处)

| 行 | 现状 | 改法 |
|---|---|---|
| `:5` | 「依次设定 5 个测试频点(100/300/1k/3k/10k Hz),激励由 AD9833 经 SPI1 产生」 | 改为单频点 1 kHz;激励源改为**外部信号源**(注明 AD9833 已移除) |
| `:9` | 「AD9833(SPI1 主机)产生正弦激励,5 个频点由内部扫描计划给出」 | 同上 |
| `:62` | 流程图「取第 k 个频率 f(100/300/1k/3k/10k)」 | 改为 1 kHz;`Freq_SourceSet` 标注为空转 |
| `:81` | 「主循环按 100 -> 300 -> ... 顺序扫描」 | 改为「固定 1 kHz」 |
| `:96` | 「5 个频点的窗口都是整数个周期...最短窗口为 300 点」 | 改为 1 kHz 的 N=3000 / 10 ms;去掉"最短 300 点" |
| `:124` | 「`kappa ≈ sqrt(2/N)`(N = 30000 时约 0.008)」 | **N 已变为 3000**(若 §3.2 不改 CYCLES)→ 底为 **0.0258** |
| `:225` | 参数表 `ADC_SAMPLER_RATE_HZ` | 保留数值,但补注"选择依据已随单频点变化" |
| `:296` | 「Fs = 300 kHz 下 5 个频率的窗口都是整数个周期」 | 改为单频点表述 |
| `:299` | 「每个频点要等一个完整窗口...1 ms(10 kHz)到 100 ms(100 Hz)」 | 改为「窗口 10 ms」 |
| `:371` | 「采样速率 300 kHz 是按 5 个频点的整数周期条件选定的」 | **重点改写** —— 见 §3.1 |

### 4.2 README 第 11 节(标定)

- `:11.1` 「对每个标定频率 `f_k`」→ 改为单频点
- 「当前 5 个扫描频点与标定点一一重合」→ 改为「当前只有 1 个频点」

### 4.3 README 第 12 节(AD9833)

**决策项**:整节保留还是删除?

- 硬件已无 AD9833 → 严格说应删除
- 但 SPI 仍保留、代码里 `ad9833.c` 仍在编译 → 保留也有理由

**建议:保留整节,但在节首加醒目提示:"当前硬件无 AD9833,本节仅存档。激励由外部信号源提供。"**
理由:代码未删,文档与代码保持一致更安全;将来若恢复也无需重写。

### 4.4 `串口屏控件清单.md`

- `:12` `t0` 示例 `f:1000` —— **已经是对的**(1 kHz 正好是这个值),无需改
- 其余无 5 频点相关内容,基本不用动

### 4.5 第 8 节「已知限制」需增删

- `:299`「每个频点要等一个完整窗口」→ 单频点下不再适用,改写
- 建议**新增一条**:外部激励源的频率精度和失真不会再被固件校验
  (原先 DFT 与 AD9833 同源,频率轴天然一致;改外部源后若频率不准,
  会直接表现为 κ 下降或相位误差,**而固件无法区分"源不准"和"DUT 特性"**)

> ⚠️ 这一点很重要:原来 AD9833 与 DFT 共享同一张频率表,**频率轴天然对齐**。
> 改用外部信号源后,若源的实际频率偏离 1 kHz(比如 ±1%),
> DFT 会在错误频率上取分量 → κ 下降 → 可能误报 E14/E15,
> **但"源不准"和"DUT 有问题"在屏幕上看起来一样**。需在文档中提醒用高精度源或先校验。

---

## 5. 不需要改的东西(已核实)

| 项目 | 保持 | 理由 |
|---|---|---|
| `ADC_SAMPLER_RATE_HZ` | 300 kHz | 300000/1000 = 300,整数周期 |
| TIM6 PSC/ARR (3/99) | 不变 | 与采样率配对,动了会静默错位 |
| `.ioc` 的 TIM6 | 不变 | 同上 |
| `CIR_FEEDBACK_RESISTOR_OHM` | 200 Ω | 与频率无关 |
| 双 ADC 同步配置 | 不变 | 与频率无关 |
| OVR 监测 (E16/E17/E18) | 不变 | 与频率无关 |
| `ADC_SAMPLER_WINDOW_MIN/MAX` | 256 / 400000 | 1 kHz 下 N=3000 不被钳位 |
| `main.c` 主循环结构 | 不变 | `for` 循环自动退化 |

---

## 6. 验证步骤

1. **编译**:armclang 6.23 全量编译 38 文件,应 0 error / 0 warning;链接通过
2. **静态核对**:
   - `FREQ_PLAN_COUNT == 1`
   - 窗口 N = 10 × 300000 / 1000 = **3000 点**
   - 窗口时长 = **10 ms** < 500 ms 超时预算
3. **上电观察**(接 1 kHz 信号源后):
   - `t0` 应恒定显示 `f:1000`
   - `t5` 应显示 `stage:LOOP`,**不应出现 E13**
   - `t6` 心跳持续跳动
   - `t7` 有电压读数、`k` 接近 1
4. **边界确认**:若 `t5` 出现 `E13 AD9833_SPI` → 执行 §3.4 的方案 B

---

## 7. 执行结果(已完成)

按"提高性能 + 更简洁 + README 只描述当前版本"执行。**代码已改完并编译通过。**

### 7.1 决策与落实

| # | 问题 | 决定 | 结果 |
|---|---|---|---|
| 1 | 窗口周期数 | **提高到 100**(性能优先) | N = 30000 点 / 100 ms,相干增益 55 → **173**,κ 噪声底 0.026 → **0.008** |
| 2 | `Freq_SourceSet()` | 改为**空实现**(2 字节) | 调用点不动;不再有 SPI 空转与误报 E13 的风险 |
| 3 | README 第 12 节 | **重写为"激励源"** | 删掉 AD9833 存档内容,改为外部源接入指南 |
| 4 | 标定表 | **精简为 1 条** | 只保留 1000 Hz |

### 7.2 超出原计划的简化(死代码清理)

按要求"更简洁",额外做了原计划未列的两件事:

- **删除 `USE/ad9833.c` / `USE/ad9833.h`**(共 298 行)。改完后它们已无任何引用,是纯死代码。
- **从 `MDK-ARM/9_30.uvprojx` 移除 `ad9833.c` 条目**。已用 `XmlDocument` 校验工程文件仍是合法 XML。

源文件数 **38 → 37**。镜像中 `AD9833_*` 符号数为 **0**(已用 fromelf 核对)。

### 7.3 E13 的处理

**保留编号占位,不改动其它错误码编号。**
- `screen.h`:注释改为"已停用:固件不再驱动 DDS,保留编号占位"
- `screen.c`:短名称改为 `DDS_SPI`
- 理由:错误码由 `s_error_names[]` 索引,改动编号会牵动全部后续码值。

### 7.4 顺带纠正的连带问题

| 项 | 原来 | 现在 |
|---|---|---|
| 300 kHz 的"选择依据" | 「5 个频率之比 1:3:10:30:100」 | 「1 kHz 下 Fs/f = 300 为整数,且有 300 倍过采样」 |
| 窗口校验表(measure.h) | 5 行(5 个频点) | 单行(1 kHz,30000 点) |
| κ 噪声底(README) | N=30000 约 0.008(当时窗口其实是 3000) | **保持 0.008** —— 窗口改成 30000 点后这个数正好对上了 |
| `spi.c` 注释 | 大量 AD9833 专有说明 | 改为"当前无从设备",保留 SPI 配置说明 |

---

## 8. 实际改动文件

| 文件 | 改动 |
|---|---|
| `USE/measure.h` | 频点计数 5→1;`Freq_SourceSet` 文档;300 kHz 依据重写;窗口表 5 行→单行;`WINDOW_CYCLES` 10→100 |
| `USE/measure.c` | 频率表 5 项→1 项;`Freq_SourceSet` 改空实现;标定表 5 条→1 条;去掉 `ad9833.h`;文档注释重写 |
| `USE/ad9833.c` | **删除** |
| `USE/ad9833.h` | **删除** |
| `USE/screen.h` | E13 标注为已停用 |
| `USE/screen.c` | E13 短名称 `AD9833_SPI`→`DDS_SPI` |
| `Core/Src/main.c` | 删除 `AD9833_Init()` 调用与 include;循环注释更新;`Freq_SourceSet` 调用注释更新 |
| `Core/Src/spi.c` | 注释改为"无从设备";去掉 AD9833 专有说明 |
| `MDK-ARM/9_30.uvprojx` | 移除 `ad9833.c` 条目(38→37 文件) |
| `README.md` | 按当前版本全面改写(见下) |
| `串口屏控件清单.md` | E13 短名称同步 |

### README 改写范围

| 位置 | 改动 |
|---|---|
| §1 用途 | 5 频点扫描 → 单频点 1 kHz + 外部源 |
| §2 结构图 | 去掉 `ad9833.h/.c` 一行 |
| §4 流程 | 流程图与说明改为单频点 |
| §5.1 窗口 | 10 周期/3000 点 → **100 周期/30000 点/100 ms**,含性能理由 |
| §5.2 相干性 | N=30000 保持一致 |
| §6 参数表 | `WINDOW_CYCLES` 10→100;移除 `AD9833_MCLK_HZ` 行;PA4 说明更新 |
| §7.2 错误表 | E13 标注已停用 |
| §8 已知限制 | 删 AD9833 量化误差条目;**新增"外部源频率精度不受固件控制"条目** |
| §9 检查表 | 项目 1/3/4/5 更新(不再要求 `ad9833.c`) |
| §10.5 待确认 | 300 kHz 依据与窗口说明更新 |
| §12 | **整章重写**:AD9833 信号源 → 激励源(SPI1 配置 + 外部源接入约束) |

---

## 9. 验证结果

**编译(armclang 6.23 + armlink):**
```
files=37  errors=0  warns=0  link=0
```
原为 38 文件;删掉 `ad9833.c` 后为 37。

**符号核对(fromelf):**
- `AD9833_*` 符号数 = **0** ✓
- `Freq_SourceSet` 存在,大小 **2 字节**(空实现)✓
- `Freq_PlanGet`、`ADC_Sampler_Init`、`CircuitID_Compute`、`ADC_IRQHandler` 均在 ✓

**工程文件:** `9_30.uvprojx` 通过 `XmlDocument` 解析,文件数 38→37,USE 组下只剩 `measure.c`、`screen.c` ✓

**编码:** 全部改动文件无 BOM、CRLF 一致 ✓

---

## 10. 执行中修正的两个自身错误(如实记录)

1. **`measure.c` 的 include 段一度被误删。** 用脚本改写 §1 时,循环边界算错,连带删掉了 `screen.h`、`tim.h` 和四个 π 常数定义,编译立即报 18 个错(未声明 `MEASURE_PI`、`Screen_ReportError` 等)。已从备份恢复并重新编译通过。
2. **README §2 结构图一度出现重复的 `├─ USE/` 行。** 行偏移导致同一行被写两次,已删除。

两处都是被编译器/读回检查捕获后修正的。

---

## 11. 残余风险

| 风险 | 等级 | 说明 |
|---|---|---|
| 窗口时长 100 ms | 🟢 低 | 远小于 500 ms 超时,安全 |
| 外部源频率不准 | 🟠 中 | 固件无法校验,已写入 README §8 与 §12.2 |
| `Uo` 削顶 | 🟠 中 | 固件不检测上限,已写入 README §12.2 |
| 无板载 DDS 可切换频率 | 🟡 低 | 设计如此;若要扫频需外部源支持 |

---

*执行完成。编译验证通过(37 文件,0 error / 0 warning,链接 OK)。*
*原计划基于 HEAD `97aa7a9` 编写;本次改动尚未提交。*
