Aliceykr/ImpedScope/串口屏控件清单.md

# 串口屏控件清单（9_30 工程）

来源:`USE/screen.c` 里真实调用的 `Screen_AppendCommand(length, "<控件名>", value)`,
以及 `Core/Src/main.c` 里的 `Screen_SetStage("...")`。已全工程搜索确认没有别处写屏。

## 一、必须新建的文本框：10 个

屏上要建 **10 个文本控件**,名字必须**完全等于** `t0`~`t9`（区分大小写）。

| 控件名 | 显示内容 | 正常示例 | 无结果时 | 生成位置 |
|---|---|---|---|---|
| `t0` | 频率（Hz） | `f:1000` | `f:-` | `USE/screen.c:301` |
| `t1` | 导纳模 \|Y\|（mS） | `Y:1.000` | `Y:-` | `USE/screen.c:313` |
| `t2` | 导纳角 φY（°） | `P:-12.34` | `P:-` | `USE/screen.c:324` |
| `t3` | 电导 G = Re[Y]（mS） | `G:0.977` | `G:-` | `USE/screen.c:336` |
| `t4` | 电纳 B = Im[Y]（mS） | `B:-0.213` | `B:-` | `USE/screen.c:348` |
| `t5` | 运行阶段 / 最近错误 | `stage:LOOP`、`stage:E12 WINDOW_TIMEOUT x12` | — | `USE/screen.c:186, 236, 406` |
| `t9` | 传递函数 `H` 的幅值(dB)与相位(°) | `H:-3.97dB A:-88.62` | `H:-` | `USE/screen.c:380` |
| `t6` | 心跳,每 500 ms +1 | `beat:1234` | — | `USE/screen.c:384` |
| `t7` | `Ui` 交流有效值（V）与相干性 | `Ui:0.1234V k:0.98` | `Ui:-` | `USE/screen.c:357, 363` |
| `t8` | `Uo` 交流有效值（V）与相干性 | `Uo:0.0988V k:0.97` | `Uo:-` | `USE/screen.c:359, 364` |

每条指令格式为 `<控件名>.txt="<值>"` 后跟 `FF FF FF`（`USE/screen.c:7`）。

`t7`、`t8` 是诊断用:每次窗口完成都会更新（**即使这一窗的结果被判为无效**）。
电压是去直流后的交流有效值（RMS,单位 V）,换算比例 `VREF+ / 65535`,默认 VREF+ = 3.3 V
（`ADC_SAMPLER_VREF_V`,`USE/measure.h`;板上基准不同要改,否则电压整体差一个固定比例）。
`k` 是相干性 kappa（1.0 = 纯单频,远小于 1 说明这个窗口里基本只有噪声）。
输入悬空、信号源没接时,`t7`/`t8` 会显示很小的幅值和很低的 `k`,
而 `t5` 显示 `stage:E14 CIR_UI_INCOH` 之类的错误 —— 两者对照就能判断是"真没信号"还是"接线/幅度问题"。

## 二、各控件的字符宽度需求

`screen.c` 里对应的缓冲区是 `SCREEN_VALUE_CHARS = 40`（`USE/screen.c:10`）,
所以单个控件**至少要能显示 40 个字符**才不会被屏截断。实测最长串:

| 控件名 | 最长实际内容 | 字符数 | 建议最小宽度 |
|---|---|---|---|
| `t0` | `f:-1234567890`（频率上限内） | ≤ 13 | 14 |
| `t1` | `Y:-999.999` | 10 | 12 |
| `t2` | `P:-179.99` | 9 | 12 |
| `t3` | `G:-999.999` | 10 | 12 |
| `t4` | `B:-999.999` | 10 | 12 |
| `t5` | `stage:E12 WINDOW_TIMEOUT x65535` | **31** | 32 |
| `t6` | `beat:4294967295` | 15 | 16 |
| `t7` | `Ui:3.3000V k:1.00` | 16 | 18 |
| `t8` | `Uo:3.3000V k:1.00` | 16 | 18 |
| `t9` | `H:-179.99dB A:-179.99` | 22 | 24 |

`t5` 是最长的一个（错误码 + 短名称 + 累计次数,`USE/screen.c:398`),
设计屏时优先保证它够宽。

## 三、`t5` 会出现的全部字符串

这些是 `t5` 可能显示的内容,做屏/查错时对照用。

阶段名（`Core/Src/main.c` 打点顺序）:

```
BOOT → CLK → PERIPH → MODULE → SCAN → LOOP
```

其中 `BOOT`（`main.c:82`）和 `CLK`（`main.c:104`）发生在 UART4 初始化之前,
只存在内存里,**屏上看不到**。`PERIPH`（`main.c:117`）起才可见,
且设置时会立即阻塞发送并保持约 150 ms。

错误短名称（`USE/screen.c` 的 `s_error_names[]`,索引即错误码）:

| 码 | 短名称 | 码 | 短名称 |
|---|---|---|---|
| E01 | `HAL_INIT` | E09 | `CIR_ZY_NAN` |
| E02 | `CIR_CFG` | E10 | `UART_TX` |
| E03 | `CIR_NAN_IN` | E11 | `UART_BUSY` |
| E04 | `CIR_UI_LOW` | E12 | `WINDOW_TIMEOUT` |
| E05 | `CIR_UO_LOW` | E13 | `DDS_SPI`(已停用,保留编号) |
| E06 | `CIR_H_NAN` | E14 | `CIR_UI_INCOH` |
| E07 | `CIR_OUT_NAN` | E15 | `CIR_UO_INCOH` |
| E08 | `CIR_H_LOW` | E16 | `ADC_DUAL_MODE` |
| | | E17 | `ADC_OVR` |
| | | E18 | `ADC_DMA` |
| | | E19 | `ADC_CLIP_UI` |
| | | E20 | `ADC_CLIP_UO` |

实际会出现的错误显示格式:

- 非致命:`stage:E02 CIR_CFG x3`（错误码 + 名称 + 累计次数）
- 致命:`stage:E01 HAL_INIT`（无次数,锁定显示）
- 无错误:`stage:LOOP`（当前阶段名）

各码的完整触发条件见 `README.md` 第 7.2 节。

## 四、串口参数

```
UART4, 9600, 8N1, 无校验
PC10 = TX（接屏 RX）
PC11 = RX（接屏 TX）
```

- 刷新周期 500 ms（`SCREEN_REFRESH_PERIOD_MS`,`USE/screen.h:13`）
- 每周期一次发 10 条指令,共用一个 320 字节缓冲（`SCREEN_TX_BUFFER_BYTES`,`USE/screen.c:9`）;
  最长情况约 265 字节,9600 bps 下约 250 ms,仍在 500 ms 周期内
- 心跳 `t6` 在任何路径下都递增,**屏上 `beat` 不动就说明 MCU 卡死了**,这是最直接的存活判据

## 五、注意

- 控件名不要加引号、不要带前缀,代码发的是裸 `t0.txt="..."`。
- 九个文本框缺一个不会报错,只是那个值看不到;`t5` 建议放在最显眼的位置。
- README 第 7 节（`README.md:241` 起）是同一份信息的完整说明,本文件是从代码反查出来的实测版。

---

生成时间:从工程代码直接提取,未做任何推测;控件名 10 个与 README 第 7 节一致。
