Aliceykr/ImpedScope/Core/Src/main.c

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
/* Includes ------------------------------------------------------------------*/
#include "main.h"
#include "adc.h"
#include "dma.h"
#include "spi.h"
#include "tim.h"
#include "usart.h"
#include "gpio.h"

/* USER CODE BEGIN Includes */
#include "measure.h"
#include "screen.h"
#include "relay_range.h"
#include "uart_debug.h"
#include <math.h>
/* USER CODE END Includes */


void SystemClock_Config(void);
void PeriphCommonClock_Config(void);
static void MPU_Config(void);
/**
  * @brief  The application entry point.
  * @retval int
  */
int main(void)
{

  /* USER CODE BEGIN 1 */
  Screen_SetStage("BOOT");
  /* USER CODE END 1 */

  /* MPU Configuration--------------------------------------------------------*/
  MPU_Config();

  /* MCU Configuration--------------------------------------------------------*/

  /* Reset of all peripherals, Initializes the Flash interface and the Systick. */
  HAL_Init();

  /* Configure the system clock */
  SystemClock_Config();

  /* Configure the peripherals common clocks */
  PeriphCommonClock_Config();

  /* USER CODE BEGIN SysInit */
  Screen_SetStage("CLK");
  /* USER CODE END SysInit */

  /* Initialize all configured peripherals */
  MX_GPIO_Init();
  MX_DMA_Init();
  MX_SPI1_Init();
  MX_UART4_Init();
  MX_ADC1_Init();
  MX_TIM6_Init();
  MX_ADC2_Init();
  MX_USART3_UART_Init();
  /* USER CODE BEGIN 2 */
  Screen_Init();                       /* 同时启动 b0(freq_change) 按键接收 */
  Screen_SetStage("PERIPH");

  UartDebug_Init();
  UartDebug_Printf("BOOT 9_30 debug uart 921600\r\n");

  /* 激励源在外部:信号源直接接到 Ui 节点(PA0_C),固件不驱动任何 DDS。
   * 因此这里没有信号源初始化步骤;SPI1 仍然初始化但不再有从设备。 */

  Measure_Init();   /* 初始化测量模块：CircuitID → Relay → ADC → 首次扫描 */
  /* USER CODE END 2 */

  /* Infinite loop */
  /* USER CODE BEGIN WHILE */
  static uint32_t last_heartbeat = 0;
  while (1)
  {
    Screen_KeyService();   /* 按键 → 请求重扫/切档/忽略 */
    Measure_Service();     /* 执行扫描或一次测量周期 */
    Screen_Poll();         /* 刷新屏幕 */

    /* 定期调用 SPI 从机轮询，用于统计和链路检测 */
    Spi_SlavePoll(NULL);

    /* 每 2 秒输出心跳，方便确认串口是否工作 */
    uint32_t now = HAL_GetTick();
    if ((now - last_heartbeat) >= 2000u)
    {
      last_heartbeat = now;
      UartDebug_Printf("HEARTBEAT tick=%lu\r\n", now);
    }
  }
    /* USER CODE END WHILE */

}

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
 /* MPU Configuration */

void MPU_Config(void)
{
  MPU_Region_InitTypeDef MPU_InitStruct = {0};

  /* Disables the MPU */
  HAL_MPU_Disable();

  /** Initializes and configures the Region and the memory to be protected
  */
  MPU_InitStruct.Enable = MPU_REGION_ENABLE;
  MPU_InitStruct.Number = MPU_REGION_NUMBER0;
  MPU_InitStruct.BaseAddress = 0x0;
  MPU_InitStruct.Size = MPU_REGION_SIZE_4GB;
  MPU_InitStruct.SubRegionDisable = 0x87;
  MPU_InitStruct.TypeExtField = MPU_TEX_LEVEL0;
  MPU_InitStruct.AccessPermission = MPU_REGION_NO_ACCESS;
  MPU_InitStruct.DisableExec = MPU_INSTRUCTION_ACCESS_DISABLE;
  MPU_InitStruct.IsShareable = MPU_ACCESS_SHAREABLE;
  MPU_InitStruct.IsCacheable = MPU_ACCESS_NOT_CACHEABLE;
  MPU_InitStruct.IsBufferable = MPU_ACCESS_NOT_BUFFERABLE;

  HAL_MPU_ConfigRegion(&MPU_InitStruct);
  /* Enables the MPU */
  HAL_MPU_Enable(MPU_PRIVILEGED_DEFAULT);

}

/**
  * @brief  This function is executed in case of error occurrence.
  * @retval None
  */
void Error_Handler(void)
{
  /* USER CODE BEGIN Error_Handler_Debug */
  /* User can add his own implementation to report the HAL error return state */
  __disable_irq();
  Screen_FatalReportBlocking();
  while (1)
  {
  }
  /* USER CODE END Error_Handler_Debug */
}
#ifdef USE_FULL_ASSERT
/**
  * @brief  Reports the name of the source file and the source line number
  *         where the assert_param error has occurred.
  * @param  file: pointer to the source file name
  * @param  line: assert_param error line source number
  * @retval None
  */
void assert_failed(uint8_t *file, uint32_t line)
{
  /* USER CODE BEGIN 6 */
  /* User can add his own implementation to report the file name and line number,
     ex: printf("Wrong parameters value: file %s on line %d\r\n", file, line) */
  /* USER CODE END 6 */
}
#endif /* USE_FULL_ASSERT */
