Aliceykr/ImpedScope/9_30.ioc

Mcu.UserName=STM32H750XBHx
PA0_C.Signal=ADCx_INP0
PA1_C.Signal=ADCx_INP1
PB10.Signal=USART3_TX
PB11.Signal=USART3_RX
PB5.Signal=SPI1_MOSI
PC10.Signal=UART4_TX
PC11.Signal=UART4_RX
PE3.GPIO_Label=RELAY_K1
PE3.Signal=GPIO_Output
PE4.GPIO_Label=RELAY_K2
PE4.Signal=GPIO_Output
PE6.GPIO_Label=RELAY_K3
PE6.Signal=GPIO_Output
PG10.Signal=SPI1_NSS
PG11.Signal=SPI1_SCK
PG9.Signal=SPI1_MISO
