Aliceykr/ImpedScope/Core/Inc/main.h

#define RELAY_K2_Pin GPIO_PIN_4
#define RELAY_K2_GPIO_Port GPIOE
#define RELAY_K1_Pin GPIO_PIN_3
#define RELAY_K1_GPIO_Port GPIOE
#define RELAY_K3_Pin GPIO_PIN_6
#define RELAY_K3_GPIO_Port GPIOE
