Aliceykr/ImpedScope/USE/uart_debug.c

#include "uart_debug.h"
#include "usart.h"
#include "relay_range.h"

#include <stdio.h>
#include <stdarg.h>

#if (UART_DEBUG_ENABLE != 0u)

static uint8_t  s_tx_buf[UART_DEBUG_TX_BUFFER_SIZE];
static volatile uint16_t s_head = 0u;
static volatile uint16_t s_tail = 0u;
static volatile uint16_t s_tx_len = 0u;
static volatile uint8_t  s_tx_busy = 0u;
static volatile uint16_t s_drop_count = 0u;
static uint32_t s_last_log_tick = 0u;
static uint8_t  s_first_log = 1u;

static int32_t UartDebug_Round(float value)
{
    return (int32_t)((value >= 0.0f) ? (value + 0.5f) : (value - 0.5f));
}

/* 空闲时从环形缓冲取下一段启动中断发送。主循环和 TxCplt 回调都会调用。 */
static void UartDebug_Kick(void)
{
    uint32_t primask;
    uint16_t head;
    uint16_t tail;
    uint16_t len;

    primask = __get_PRIMASK();
    __disable_irq();

    if (s_tx_busy != 0u)
    {
        __set_PRIMASK(primask);
        return;
    }

    head = s_head;
    tail = s_tail;
    if (head == tail)
    {
        __set_PRIMASK(primask);
        return;
    }

    if (head > tail)
    {
        len = (uint16_t)(head - tail);
    }
    else
    {
        len = (uint16_t)(UART_DEBUG_TX_BUFFER_SIZE - tail);
    }

    s_tx_len  = len;
    s_tx_busy = 1u;
    __set_PRIMASK(primask);

    if (HAL_UART_Transmit_IT(&huart3, &s_tx_buf[tail], len) != HAL_OK)
    {
        s_tx_busy = 0u;
    }
}

void UartDebug_Init(void)
{
    s_head = 0u;
    s_tail = 0u;
    s_tx_len = 0u;
    s_tx_busy = 0u;
    s_drop_count = 0u;
    s_last_log_tick = 0u;
    s_first_log = 1u;
}

void UartDebug_Write(const uint8_t *data, uint16_t length)
{
    uint16_t used;
    uint16_t free_space;
    uint16_t head;
    uint16_t index;
    uint32_t primask;

    if ((data == (const uint8_t *)0) || (length == 0u))
    {
        return;
    }

    primask = __get_PRIMASK();
    __disable_irq();
    head = s_head;
    used = (head >= s_tail) ? (uint16_t)(head - s_tail)
                            : (uint16_t)(UART_DEBUG_TX_BUFFER_SIZE - s_tail + head);
    free_space = (uint16_t)(UART_DEBUG_TX_BUFFER_SIZE - 1u - used);
    __set_PRIMASK(primask);

    if (length > free_space)
    {
        ++s_drop_count;              /* 缓冲不够就整段丢弃，避免半行日志 */
        return;
    }

    for (index = 0u; index < length; ++index)
    {
        s_tx_buf[head] = data[index];
        head = (uint16_t)((head + 1u) % UART_DEBUG_TX_BUFFER_SIZE);
    }
    s_head = head;

    UartDebug_Kick();
}

void UartDebug_Printf(const char *format, ...)
{
    char buffer[192];
    va_list args;
    int length;

    if (format == (const char *)0)
    {
        return;
    }

    va_start(args, format);
    length = vsnprintf(buffer, sizeof(buffer), format, args);
    va_end(args);

    if (length <= 0)
    {
        return;
    }
    if (length >= (int)sizeof(buffer))
    {
        length = (int)sizeof(buffer) - 1;
    }

    UartDebug_Write((const uint8_t *)buffer, (uint16_t)length);
}

void UartDebug_LogEvent(const char *event)
{
    if (event == (const char *)0)
    {
        return;
    }
    UartDebug_Printf("EVT %s\r\n", event);
}

void UartDebug_LogMeasurement(const FRF_Point_t *point,
                              const ADC_Window_t *window,
                              uint8_t range_index)
{
    uint32_t now;
    long y_us;
    long p_mdeg;
    long g_us;
    long b_us;
    long h_db;
    long h_deg;
    long r_ohm;
    long ui_mv;
    long uo_mv;

    if ((point == (const FRF_Point_t *)0) || (window == (const ADC_Window_t *)0))
    {
        return;
    }

    now = HAL_GetTick();
    if ((s_first_log == 0u) &&
        ((int32_t)(now - s_last_log_tick) < (int32_t)UART_DEBUG_MIN_INTERVAL_MS))
    {
        return;
    }
    s_first_log = 0u;
    s_last_log_tick = now;

    h_db  = (long)UartDebug_Round(point->h_magnitude_dB * 100.0f);
    h_deg = (long)UartDebug_Round(point->h_phase_deg * 100.0f);
    r_ohm = (long)UartDebug_Round(Relay_GetOhm());
    ui_mv = (long)UartDebug_Round((float)(window->ui_rms * ADC_SAMPLER_LSB_TO_V * 1000.0));
    uo_mv = (long)UartDebug_Round((float)(window->uo_rms * ADC_SAMPLER_LSB_TO_V * 1000.0));

#if (CIR_DUT_TOPOLOGY == 1u)
    y_us   = (long)UartDebug_Round(point->y_mag_siemens * 1e6f);
    p_mdeg = (long)UartDebug_Round(point->y_phase_deg * 1000.0f);
    g_us   = (long)UartDebug_Round(point->y_conductance_siemens * 1e6f);
    b_us   = (long)UartDebug_Round(point->y_susceptance_siemens * 1e6f);

    UartDebug_Printf("f=%lu,Y_uS=%ld,P_mdeg=%ld,G_uS=%ld,B_uS=%ld,H_dB_x100=%ld,H_deg_x100=%ld,R_ohm=%ld,range=%u,Ui_rms_mV=%ld,Uo_rms_mV=%ld\r\n",
                     (unsigned long)window->frequency_hz,
                     y_us, p_mdeg, g_us, b_us, h_db, h_deg, r_ohm,
                     (unsigned)range_index, ui_mv, uo_mv);
#else
    (void)y_us;
    (void)p_mdeg;
    (void)g_us;
    (void)b_us;

    UartDebug_Printf("f=%lu,H_dB_x100=%ld,H_deg_x100=%ld,R_ohm=%ld,range=%u,Ui_rms_mV=%ld,Uo_rms_mV=%ld\r\n",
                     (unsigned long)window->frequency_hz,
                     h_db, h_deg, r_ohm,
                     (unsigned)range_index, ui_mv, uo_mv);
#endif
}

void UartDebug_LogCompare(const FRF_Point_t *dft, const Spi_Frame_t *spi)
{
    /* FPGA top.v 提供频率与相对相位测值，与 ADC DFT 进行比对 */
    int32_t df_hz = (int32_t)spi->frequency_hz - (int32_t)dft->frequency_hz;
    int32_t dphi_mdeg = (int32_t)((spi->h_phase_deg - dft->h_phase_deg) * 1000.0f);

    /* 输出 FPGA 测值与 DFT 测值差异 */
    UartDebug_Printf("COMPARE seq=%u,fpga_f=%lu,dft_f=%lu,df=%ld,fpga_phi=%ld,dft_phi=%ld,dphi_mdeg=%ld,p_cnt=%u,f0_cnt=%u,ok=%lu,err=%lu\r\n",
                     (unsigned)spi->seq,
                     (unsigned long)spi->frequency_hz,
                     (unsigned long)dft->frequency_hz,
                     (long)df_hz,
                     (long)(spi->h_phase_deg * 1000.0f),
                     (long)(dft->h_phase_deg * 1000.0f),
                     (long)dphi_mdeg,
                     (unsigned)spi->phase_cnt,
                     (unsigned)spi->freq0_cnt,
                     (unsigned long)Spi_SlaveValidCount(),
                     (unsigned long)Spi_SlaveErrorCount());
}

uint16_t UartDebug_DropCount(void)
{
    return s_drop_count;
}

void UartDebug_OnError(void)
{
    s_tx_busy = 0u;
    (void)HAL_UART_AbortTransmit(&huart3);
    UartDebug_Kick();
}

/* HAL 的弱回调；只处理 USART3，UART4 仍由 screen.c 的阻塞发送负责。 */
void HAL_UART_TxCpltCallback(UART_HandleTypeDef *huart)
{
    if (huart->Instance != USART3)
    {
        return;
    }

    s_tail = (uint16_t)((s_tail + s_tx_len) % UART_DEBUG_TX_BUFFER_SIZE);
    s_tx_busy = 0u;
    UartDebug_Kick();
}

#else /* UART_DEBUG_ENABLE == 0：全部编译为空，避免占用空间 */

void UartDebug_Init(void)
{
}

void UartDebug_Write(const uint8_t *data, uint16_t length)
{
    (void)data;
    (void)length;
}

void UartDebug_Printf(const char *format, ...)
{
    (void)format;
}

void UartDebug_LogMeasurement(const FRF_Point_t *point,
                              const ADC_Window_t *window,
                              uint8_t range_index)
{
    (void)point;
    (void)window;
    (void)range_index;
}

void UartDebug_LogEvent(const char *event)
{
    (void)event;
}

void UartDebug_LogCompare(const FRF_Point_t *dft, const Spi_Frame_t *spi)
{
    (void)dft;
    (void)spi;
}

uint16_t UartDebug_DropCount(void)
{
    return 0u;
}

void UartDebug_OnError(void)
{
}

#endif /* UART_DEBUG_ENABLE */
