Aliceykr/ImpedScope/(commit log)

2026-09-29 feat: add SPI1 slave DMA receiver with FFT frame parser
2026-09-29 refactor: switch SPI slave to 8-bit byte reception, decouple user logic
2026-09-29 feat: add circuit frequency-response identification (freq/mag/phase)
2026-09-30 规范代码注释并重写工程说明
2026-10-09 feat: add UART4 serial screen output for frequency-response results
    Generate UART4 (PC10/PC11, 9600 8N1) in CubeMX and add USE/screen.c to
    send freq, |Z| and Z phase to the screen every 500 ms. Add the debug
    screen plan for the next iteration.
2026-10-09 修复阻抗相位符号并完善串口屏调试显示
    修正 Z 虚部符号（Z = -R·conj(H)/|H|²），使电容负载相位为 -90°；
    将 |H| 门限独立为 CIR_H_MIN_MAG；串口屏改为 t0~t4 五个文本框，
    增加心跳、运行阶段和 E01~E16 错误码上报，并同步更新计划与 README。
2026-10-09 补充频响计算文档并删除串口屏计划文档
    README 新增计算方法、数据处理流程、参数表、串口屏控件和错误码说明，
    替代已删除的 PLAN_debug_screen.md；circuit_id 补充注释，说明各步骤原理。
2026-10-10 feat: 改为 16 字节定点帧接收并启用 CS 硬件片选
    - SPI1 改为硬件 NSS（PA4），EXTI4 双边沿检测帧开始与结束
    - DMA 改为普通模式，每次收一帧 16 字节，收完重新装载
    - 解析 12 位有符号分量与 13 位峰值 bin，替换原 22 字节 float 帧
    - 新增 E17 BIN_MISMATCH，两路峰值 bin 不一致时丢帧并单独计数
    - 新增 HAL_SPI_ErrorCallback，SPI 错误后中止并重新装载
    - 新增 SCREEN_SPI_TEST 通信测试界面，显示收包计数和原始帧
    - 更新 README：帧协议、接收流程、错误码表及已知限制
    注：FPGA 侧配置字位序与峰值选择逻辑尚未修改，见 README 第 9 节。
2026-10-11 修复致命路径死锁,并订正 README 结构与幅值门限
    screen.c:致命上报原来走 HAL_MAX_DELAY。关中断后 SysTick 已停,HAL 的
    tick 超时形同虚设(HAL_MAX_DELAY 直接跳过超时判断,有限值也因 tick 冻结
    而永不到期),UART 无响应时会在这里死等,反而发不出致命码。改为新增
    Screen_SendT4Raw(),用纯计数器有界轮询 TXE/TC,发送前清掉残留的 IT/DMA
    发送请求位,结束后还原 gState,不再依赖 HAL 状态与 SysTick。
    Screen_SendT4Blocking() 保留,供中断开启的 Screen_SetStage() 使用。
    README:9.1 节原本排在第 9 节之前,导致节内"见本节上方'已知限制'"实际
    指向下方。已把第 9 节的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
2026-10-12 新增 ADC1 双通道定时器触发采样，并修复 NSS EXTI4 中断丢失
    ADC：
    - 新增 USE/adc_sampler.c/h，ADC1 扫描两路（PA0_C、PA1_C），DMA 循环写入缓冲区
    - 通道：rank1 为 PA0_C（ADC1_INP0，DUT 电压），rank2 为 PA1_C（ADC1_INP1，电流转换电压）
    - 由 TIM6 TRGO（1 MHz）触发，关闭连续转换，ADC_Sampler_Init() 中启动 ADC DMA 和 TIM6
    - 对外提供 ADC_Sampler_GetLatest()，尚未接入上层逻辑
    - .ioc 与 CubeMX 生成的 adc.c、tim.c 同步
    NSS：
    - EXTI4_IRQHandler 移到 stm32h7xx_it.c 的 USER CODE 区，CubeMX 重新生成时不会丢失
    - 中断使能仍由 spi.c 的 USER CODE 负责
    同时同步 .mxproject、uvprojx、uvop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
2026-10-12 README 补充 ADC 采样说明
    - 功能列表加入 ADC1 双通道采样（PA0_C、PA1_C，TIM6 触发，DMA 循环）
    - 工程结构加入 adc_sampler、adc.c、tim.c
    - 编译与维护检查项加入 ADC_Sampler_Init 调用和 ADC1 配置要求
    - 新增第 11 节：通道与引脚、采样时序、接口、待确认事项
2026-10-12 ADC1/ADC2 共用 TIM6 触发，改为两路单通道 DMA 采样
    - ADC1（PA0_C）和 ADC2（PA1_C）各自单通道，共用 TIM6 TRGO 触发，保持同步
    - 两路 DMA 改为循环模式，ADC 时钟 /2（37.5 MHz，低于 16 位上限）
    - adc_sampler：两路分别校准、分别启动 DMA，最后启动 TIM6；ADC1 回调更新 DUT 电压，ADC2 回调更新电流电压
    - .ioc 中新增键加入 IPParameters，CubeMX 重新生成时不会丢失
    TIM4：
    - .ioc 中移除 TIM4 配置，TIM6 相关引脚序号顺延
    README：
    - 补充 ADC 时钟、校准和采样时序说明
    - 串口屏相关描述仍为 ADC 电压版本，与代码不一致，待修正
    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
2026-10-12 SPI1 内核时钟改为 PLL2 75 MHz，修正 README
    时钟：
    - SPI1 内核时钟由 CLKP 改为 PLL2（75 MHz），`.ioc` 与生成代码一致
    - CKPER 改为 HSE 25 MHz，HSI 关闭（CubeMX 重新生成的结果）
    - SCK 由 FPGA 提供，内核时钟不决定传输速率；从机能稳定接收的上限需实测
    - 串口屏恢复为 500 ms 刷新，测试模式 t0~t2 显示 cs、full、hdr 计数
    - ADC 描述改为 ADC1、ADC2 各自单通道，共用 TIM6 触发
    - 串口屏不再显示 ADC 电压，删除相关描述
    - SPI 配置补充内核时钟和 SCK 上限说明
    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
2026-10-12 改为 SPI 频率帧 + ADC 单频 DFT 计算，更新 README 并加入标定方法
    SPI（临时协议）：
    - 帧改为 8 字节 [0x07][0x08][频率 4 字节大端][0x00][0x00]，帧头帧尾不变
    - 频率范围 1 Hz ~ 500 kHz，超出或为 0 报 E03
    - 旧的 16 字节数据帧解析用 #if 0 注释保留
    ADC 与计算：
    - ADC1（PA0_C，Ui）、ADC2（PA1_C，Uo）两路在同一 DMA 块边界开始累加，窗口起点对齐
    - 每个频率开一个窗口，N = round(10 * fs / f)，限制在 [1024, 1000000]
    - 对两路做单频 DFT（去直流），H = Uo / Ui，Z = -R / H，Y = -H / R
    - 幅值下限 CIR_INPUT_MIN_AMP / CIR_OUTPUT_MIN_AMP 为占位值 4 码值
    - 去掉旧的 FFT 常量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
2026-10-13 采样率改 300 kHz，输出改为导纳 |Y|/φY/G/B，新增频率扫描与标定模块
    - TIM6 由 1 MHz 改为 300 kHz（PSC=3/ARR=99），ADC_SAMPLER_RATE_HZ 同步改为 300000.0f
    - 窗口钳位范围改为 [256, 400000]，5 个频率的窗口全部为整数个周期，DFT 泄漏为零
    - 反馈电阻 1000 Ω 改为 200 Ω（单挡覆盖 0.1~10 mS 不削顶）
    - FRF_Point_t 增加 y_conductance_siemens / y_susceptance_siemens，输出 G、B
    - 新增 calib.c/h：双路增益比与固定相位差修正，当前为恒等表，待标定填数
    - 新增 freq_plan.c/h：5 频率扫描计划，AD9833 驱动为空桩
    - 主循环改为顺序扫描 5 个频率，改用墙钟超时；失败或超时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
2026-10-13 9_30.ioc: TIM6 采样率修正为 300 kHz（PSC=3、ARR=99）
    原 .ioc 中 TIM6 为 PSC=11、ARR=9，即 120 MHz/12/10 = 1 MHz，而 tim.c 已改为 PSC=3、ARR=99 的 300 kHz，adc_sampler.h 的 ADC_SAMPLER_RATE_HZ 也是 300 kHz。用 CubeMX 重新生成代码会把硬件触发率改回 1 MHz，软件频率轴却仍是 300 kHz，DFT 频率轴静默错 3.33 倍且不报任何错。此处把 .ioc 对齐到代码。
2026-10-13 USE 合并为 measure/screen 两个模块，删除废弃的 SPI 接收路径
    合并（USE 由 12 个文件减到 4 个）：
    - freq_plan、adc_sampler、circuit_id、calib 合并为 measure.h/.c，内部分 4 节：频率扫描计划、ADC 采样与单频 DFT、两路标定、H/Z/Y 计算。函数名、宏、数据结构全部不变；标定两个接口改为文件内 static。
    - 算法代码逐字搬运，只把三个模块各自的 π 常数统一成 MEASURE_PI/MEASURE_TWO_PI。
    删除不可达的死代码：
    - spi_receiver.h/.c（main.c 已不再调用且 EXTI4 已关断）、screen.c 里的 SCREEN_SPI_TEST 测试界面分支与该宏。
    - E02/E03/E06/E17 保留编号占位，不重编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
2026-10-13 README 同步 USE 结构变更与废弃路径的删除
    工程结构树改为 measure.h/.c 与 screen.h/.c；第 4 节标注 SPI 接收实现已删除（附 git show 取回方式）并把协议描述降为历史存档；第 5、6、11、12 节的文件链接与第 7 节参数表所在文件列改指 measure；第 8 节补上缺失的 t6 心跳行，删掉整节 8.1 通信测试模式，8.2/8.3 顺次改为 8.1/8.2；错误码表把 E02/E03/E06 标为已弃用保留编号、circuit_id.c 出处改为 measure.c、E18 行去掉重复的类型说明；第 9 节两条 FPGA 相关的过时限制改写为内部扫描的实际约束并删掉 SCREEN_SPI_TEST 一条；第 10 节维护清单第 1、6 条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
2026-10-13 接入 AD9833 激励源：SPI1 改为 16 位主机，新增 USE/ad9833.c/.h 与 E19
    驱动来源与取舍：
    - 以 ad9833_drivers_found/ad9833_fixed 为基础，它是四份候选中唯一位定义与数据手册 Table 8/Table 15 完全相符的一份；传输层按本工程重写。
    - 位定义 D8 RESET / D7 SLEEP1 / D6 SLEEP12 / D5 OPBITEN / D3 DIV2 / D1 MODE。仓库里 ad9833_driver 与 2020_diansai 两份把这四位整体写高一位（RESET 写到 D9 保留位），Base_2025 另有 DIV2/MODE 错位，均未采用。
    SPI1 适配（原为已废弃的 FPGA 从机路径）：
    - 主机、SPI_DATASIZE_16BIT、CPOL=High / CPHA=1Edge（Mode 2，AD9833 在 SCLK 下降沿锁存数据）、软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
2026-10-13 README 同步 AD9833 章节并订正过时描述
    - 新增第 13 节 AD9833 信号源：接线表、SPI1 配置及理由、Table 8 位定义、频率字与量化误差、与扫描计划的配合。
    - 第 1 节用途与功能列表改为当前实现（激励源已接入，删掉 FPGA 帧接收的旧功能描述）。
    - 第 2 节结构树补上 USE/ad9833.h/.c；spi.c、stm32h7xx_it.c 的说明同步。
    - 第 4 节存档说明与引脚注记：PA4/NSS 与 EXTI4 已随旧路径移除，PG11/PB5/PA4 现用于 AD9833。
    - 第 5 节流程图：Freq_SourceSet 不再是空桩。
    - 第 7 节参数表补 AD9833_MCLK_HZ；PA4 说明改为由 ad9833.c 手动配置。
    - 第 8.2 节错误码表补 E19；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
2026-10-13 ADC 改为主从硬件同步采样：一次 TIM6 触发同时采两路，结果经 CDR 由 ADC1 的 DMA 搬运
    动机：
    - 原方案两路 ADC 各自被同一个 TIM6 TRGO 触发，采样时刻相差几百纳秒，10 kHz 时约 1.1° 相位误差，约占 φY 预算（4.5°）的四分之一。
    - 在软件里事后扣掉这个固定延迟也能收敛，但硬件同步是根因修复：不依赖标定表，也不随频率与源阻抗变化而失配。
    adc.c：
    - multimode.Mode 由 ADC_MODE_INDEPENDENT 改为 ADC_DUALMODE_REGSIMULT，并补上 DualModeData = ADC_DUALMODEDATAFORMAT_32_10_BITS（16 位分辨率）与 TwoSamplingDelay = ADC_TWOSAMPLINGDELAY_1CYCLE（此模式下硬件忽略）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
2026-10-13 README: 只保留当前实现的描述，删掉旧版本痕迹
    动机：README 里混着历代实现的说明（SPI 频率帧接收协议、已废弃的错误码编号、
    「本版新增」「已删除」这类版本对比措辞），读者要先分辨哪句是当前实现。
    现在只描述当前这一版。
    文件：README.md（518 -> 454 行）
    - 删除「SPI 频率帧接收协议（已删除）」整节（存档提示块 + 协议说明共 57 行），
    其后各节顺次前移一位（原 5~13 节 -> 现 4~12 节），全文交叉引用同步更新。
    - 错误码表删掉 E02~E06、E17 共 6 行已废弃编号。
    - 去掉「不再由 SPI 帧提供」「负号被删掉了」「本版新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
2026-10-13 错误码枚举重排为 E01-E13，并清理注释里的旧版本痕迹
    动机：E02/E03/E06/E17 是从未用过的占位编号，散在枚举中间让串口屏 DEBUG.ErrCode 的
    报错编号跳号。现在枚举连续为 E01-E13，编号与文档一一对应。
    映射（旧->新）：E07->E02、E08->E03、E09->E04、E10->E05、E11->E06、E12->E07、
    E13->E08、E14->E09、E15->E10、E16->E11、E18->E12、E19->E13；E01 不变；
    SCREEN_ERROR_CODE_MAX 19->13。
    文件：
    - USE/screen.h 枚举删掉 E02/E03/E06/E17 占位项并重编号，注释同步
    - USE/screen.c s_error_names[] 同步为 13 项
    - USE/measure.c (10 处) / Core/Src/main.c (3 处) / USE/screen.c (3 处) 报错调用改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
2026-10-13 判定窗口里是否真有单频信号：新增相干性判据 E14/E15，串口屏增加 t7/t8 诊断
    动机：信号源没接、输入悬空时，屏幕仍显示一套看着正常的 |Y|、φY、G、B。
    根因是原来只有幅值门限：噪声落在测量频点上的分量（2|S|/N）也很容易超过
    CIR_INPUT_MIN_AMP = 4 个码值；而 AD9833 是只写器件、没有回读，写没写进去
    HAL 一律返回 OK，于是"没接"这件事在整条链路上无人发现，算出来的
    H = Uo·conj(Ui)/|Ui|² 就是两路本底噪声的比值 —— 数值不大不小，且每个窗口都在变。
    判据：kappa = (2|S|/N) / (sqrt(2) · RMS_ac)。窗口里是单频正弦时 kappa = 1.0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
2026-10-13 新增串口屏控件清单：9 个文本框的内容、宽度与错误码短名称对照
    从 USE/screen.c 与 Core/Src/main.c 反查出实际写屏的每一处，供建屏和现场查错使用：
    - 9 个文本框 t0~t8 的显示内容、正常示例、无结果时的取值、生成位置（screen.c 行号）
    - 每个控件的最长实际内容与建议最小宽度；t5 最长（stage:E12 WINDOW_TIMEOUT x65535，30 字符），
    其次是新增的 t7/t8（Ui:32767.00 c:1.00，18 字符）
    - t5 会出现的全部字符串：阶段名 BOOT → CLK → PERIPH → MODULE → SCAN → LOOP（BOOT/CLK 在
    UART 就绪之前，屏上看不到），以及 E01~E15 的短名称与显示格式（非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
2026-10-13 串口屏 t7/t8 改为显示电压（V），新增 ADC_SAMPLER_VREF_V
    原来的 t7、t8 显示的是 ADC 码值下的单频幅值（如 Ui:123.45）与相干性 c：码值不直观，
    "c" 的含义还得对着文档才知道。
    - USE/measure.h：新增 ADC_SAMPLER_VREF_V（默认 3.3 V = VREF+ = VDDA）与
    ADC_SAMPLER_LSB_TO_V（= VREF+ / 65535）；注释说明基准与实际不符时显示的电压会整体
    差一个固定比例，但不影响 H/Z/Y（它们是两路之比或对 R 的比值）。幅值注释补上
    "该幅值是单频分量的峰值，其 1/sqrt(2) 即该分量的有效值"。
    - USE/measure.c：Screen_SetDebug() 改送两路去直流后的交流有效值（RMS，单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
2026-10-14 双 ADC 同步配置移入 USER CODE 区,新增 ADC 溢出监测与配置回读校验
    双 ADC 同步模式在 .ioc 里没有对应选项,原先 multimode 配置写在 CubeMX
    生成区,重新生成会被改回独立模式且不报错(两路不再同时采样,H 静默偏掉)。
    本次把这部分移到 USER CODE BEGIN ADC1_Init 2 区,生成区恢复为 CubeMX 的
    默认输出,重新生成不再丢失配置。
    同时补齐溢出监测:此前 HAL 会开 ADC_IT_OVR,但 NVIC 未使能 ADC_IRQn、
    也没有 ErrorCallback 实现,溢出被静默吞掉,会用陈旧样本算出频响。
    现新增 ADC_IRQHandler 与 HAL_ADC_ErrorCallback,检出 OVR 即作废当前窗口。
    主要改动:
    - adc.c: 同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
2026-10-14 改为单频点 1 kHz 测量,激励源改为外部信号源
    硬件上已无板载 DDS,激励改由外部信号源直接加到 Ui 节点。原来为 5 频点
    扫描设计的配置随之调整,并删除已无引用的 DDS 驱动。
    频率与采样:
    - FREQ_PLAN_COUNT 5 -> 1,频率表改为 { 1000u }
    - ADC_SAMPLER_WINDOW_CYCLES 10 -> 100(窗口 3000 -> 30000 点 / 100 ms)
    相干增益 sqrt(N) 由 55 提升到 173,kappa 噪声底由 0.026 降到 0.008,
    相对 CIR_MIN_COHERENCE(0.2)有 25 倍余量;100 ms 远小于 500 ms 超时预算
    - 采样率 300 kHz 不变(300000/1000 = 300 仍为整数,窗口是整数个周期)
    激励源接口:
    - Freq_SourceSet() 改为空实现(调用点不动,保持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
2026-10-15 串口屏新增 t9 显示 H 的幅值与相位,为标定提供直接读数
    动机:
    标定要读的正是 H 本身(直通测试时理论值 0 dB / 0°,实测偏差就是标定表要填的
    两个数),但屏上此前只有由 H 变换出来的 |Y|、φY、G、B,读数得从 φY 反推
    (∠H = φY − 180°),既麻烦又容易在 atan2 的 ±180° 边界上读错。加一行直接显示
    H,标定和事后核对都用它。
    文件:
    - USE/screen.c 新增 t9 指令,格式 "H:%.2fdB A:%.2f";无有效结果时显示 "H:-"。
    位置放在 t8 之后、t6 之前,与构建顺序无关,只为让源码里诊断类
    控件相邻。
    - USE/screen.h Screen_Poll() 注释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
2026-10-15 删除了多余文件
2026-10-17 支持屏幕按键切换测量频率并稳定串口刷新
2026-10-17 五个频率档位按实际测量频率更新 t10
2026-10-17 切换频率后立即清掉上一频率的显示结果
2026-10-18 自动识别五档频率并支持强制刷新
2026-10-18 添加设计报告
2026-10-18 设计报告改为Word文档
2026-10-21 新增模拟开关自动量程（4 档反馈电阻）
    - 新增 USE/analog_switch.c/.h：74HC4052 四档 27/270/2.7k/27k，PE2/PE3 控制，按 Uo 峰值自动选档
    - measure：运行时反馈电阻 + ADC_Sampler_Restart
    - main：上电/换频选档 + 运行时换档
    - ioc：PE2/PE3 GPIO，UART4 波特率改 921600
    - README：虚地改为 1.65 V
    - 新增 PLAN-反馈电阻自动切换.md
2026-10-22 按 1 Vpp 源修正四档反馈电阻
    - 实际激励为 1 Vpp、1.65 V 偏置，Ui 峰值 0.5 V；10 mS 时电流 5 mA
    - 四档改为 150 Ω / 1.5 kΩ / 15 kΩ / 150 kΩ：150 Ω 档 10 mS 输出 1.25 V（Ron 40%），其余三档 Ron 占比 ≤6.25%
    - 旧 27/270/2.7k/27k 在 0.5 V 峰值下 270 Ω 档 10 mS 会削顶、27 Ω 档 Ron 占 79%，已废弃
    - 同步更新 analog_switch.h 推导、main.c 注释与计划文档
2026-10-22 新增 USART3 调试日志串口（PD8 TX，921600）
    - USART3 TX-only：PD8/AF7，921600 8N1，NVIC 优先级 5
    - 新增 USE/uart_debug.c/.h：1024 字节环形缓冲、非阻塞 TX、每有效测量一行
    - main/it/screen 接入；screen 的 UART 错误回调增加 USART3 分支
    - .ioc 同步 PD8/USART3/NVIC/IP；uvprojx 加入 uart_debug.c
    - 新增 PLAN-第二路串口.md
2026-10-22 新增 MICU-OmniProbe 文档
2026-10-22 重写 README（v2.0，按当前固件）
    - 自动选频 5 档 + 自动量程 4 档（150/1.5k/15k/150k），R_eff = R + Ron
    - 1.65 V 虚地、1 Vpp 源、USART3 PD8 调试口、t10 = H 相位
    - 逐档 R_eff/H_thru 标定说明；移除旧版单频/200Ω/恒等标定/t10 频率等描述
    - 同步修正 analog_switch.h 的 15k/150k 覆盖区间
2026-10-27 调试串口改PB10，固定1.5k并完成1k/10k标定
    USART3调试TX从PD8改到PB10；模拟开关按E2=A0/E3=A1和15/150/1.5k/15k更新，当前SW_ENABLE=0固定1.5k；t10显示反馈档位；按1010Ω纯电阻完成1k/10k标定；新增SDG1032X控制脚本并更新README/PLAN。
2026-10-27 继电器三档量程：4052四档自动量程改为3路继电器固定1.5k
    - 新增 USE/relay_range.c/.h：K1=150Ω/K2=1.5kΩ/K3=15kΩ，PE2/PE3/PE4
    高电平闭合，上电只闭合K2（默认档），固定按1500Ω计算，无运行期切档
    - 删除 USE/analog_switch.c/.h（74HC4052 自动量程）及工程引用
    - 9_30.ioc：PE2/PE3 标签改 RELAY_K1/K2，新增 PE4 RELAY_K3，PinsNb=20
    - main.h/gpio.c：CubeMX 风格继电器引脚宏；MX_GPIO_Init 配置三脚并写低
    - main.c：Relay_Init 替代 Switch_Init，删除量程分支/range_ready/Window_UoPeakV
    - README 升 v3.0（继电器三档/固定1.5k，范围与 s_calib 对齐）
    - 删除 MICU-OmniProbe.md 与两个历史 PLAN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
2026-10-27 b0 双击切档：单击重扫、双击循环切换继电器档位；文档与 verify.sh 同步
    - relay_range 新增 Relay_Set()/Relay_Next()（先断后合，越界/同档防护）
    - screen 按键改点击队列：ISR 记时间戳，PollKey 300ms 窗口判单击/双击
    - 新增 Screen_FlushRange() 切档立即补发 t10
    - main.c 双击分支：Relay_Next → 同步 R_eff → 清结果/错误 → 重启采样
    - README/PLAN-继电器三档量程 同步双击切档；verify.sh EXPECT_CODE=51314
2026-10-27 审查修复：清除全部'固定 1.5k/不做切档'旧表述，PollKey 改单临界区
    - relay_range.h/screen.h/uart_debug.h/screen.c 注释同步三档可切
    - README：§1/§2/§3/§7/§8/§10/§13/§15/§17/§18 共 8 处更新
    - PLAN-继电器三档量程：标题/§1/§4.2/§10 同步；PLAN-双击切档代码片段改单临界区
    - PollKey 竞态修复：读快照与改队列并入同一临界区（删 ClickReset/ClickKeepLast）
    - README 体积 Code=51322；verify.sh EXPECT_CODE=51322
    - §17 双击测试编号改 D1-D5 避免与 USART3 的 T1-T7 重号；补扫描期间双击已知行为
2026-10-27 补 .gitignore：忽略根目录编译输出 build-rev*/，移除误提交的 build-rev7/link.log
2026-10-27 .gitignore：补 build-rev*/ 规则
2026-10-27 文档编号体系理清：USART3=T、继电器=R、b0 双击=B；删 PLAN §1 重复行
    - PLAN-双击切档 §1 删除重复的 D3/D4/D5 行；§7 测试 T1-T9 → B1-B9；§10 验收引用同步
    - PLAN-继电器 §7 测试 T1-T7 → R1-R7（R3 改'上电默认档 R'、R5 改'无自动切档'）；§10 任务清单同步
    - README §17：继电器组 T1-T6 → R1-R6、双击组 D1-D5 → B1/B2/B4/B5/B6
    - README §4 措辞：'R_eff 恒为 1500 Ω' 改 '上电时 R_eff = 1500 Ω（双击可切）'
    - 删除根目录编译输出 build-rev7/（已加 .gitignore）
2026-10-27 修 3 处'只有一档'漏网表述：引脚表/§13.2/relay_range.c 注释改为三档可切
2026-10-27 删除两个 PLAN 文档（继电器三档量程/双击切档），README §18 改为实施记录并清理引用
2026-10-27 relay_range.h 清除已删 PLAN 的死引用
2026-10-28 继电器控制脚改为PE3/PE4/PE6
    K1=PE3(150Ω)、K2=PE4(1.5kΩ默认)、K3=PE6(15kΩ)；同步.ioc、GPIO初始化和README，t10档位显示逻辑不变。
2026-10-28 b1 单击切档：三键三字节协议替换 b0 单击/双击
    按键协议从 b0 单击重扫、双击切档 改为三键单击：
    b0=01 01 01 强制重扫；b1=01 01 02 切档；b2=01 01 03 预留静默。
    b0 双击不再切档，等价于两次重扫。
    USE/screen.h: 枚举改 SCREEN_KEY_B0/B1/B2，删 SCREEN_DOUBLE_CLICK_MS。
    USE/screen.c: 二进制改严格三状态机（少一个帧头即丢弃）；ASCII 六字符
    匹配器修复死锁（原先在 event==NONE 时无条件复位，把未收满的进度清零，
    match 永远在 0/1 振荡、ASCII 一个键都触发不了）；单击/双击时间戳队列
    改按键事件队列（容量 4），中断入队主循环出队，DFT 窗口阻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
2026-10-28 修复按钮串键、b0 紊乱与响应慢问题
    按 PLAN-按钮问题修复.md 实施以下修复：
    1. b0 事件合并/去重（优先级 2）
    - 增加 s_b0_pending 标志，同一时间最多保留一个待处理的 b0 请求
    - 正在扫描时再次按 b0，只记录待处理，不堆多个事件
    - 避免 b0 连续按导致多次重扫、队列积压、响应慢
    2. Beat 复位时机优化（优先级 2）
    - B0 事件到达时立即设置 s_beat_reset_pending 标志（在中断中）
    - Screen_Poll() 检测到标志后应用复位
    - 只有 B0 会设置 beat 复位标志，B1 和 B2 不会
    3. B1 低延迟处理（优先级 3）
    - 添加 Screen_PeekKey() 函数，窥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
2026-10-28 重构 main.c：按职责拆分到现有模块，主循环简化为三个调用
    按 PLAN-main瘦身.md 实施，不新增任何文件，所有逻辑放回现有模块：
    ## Phase 1: 搬 FreqScan_Select
    - FreqScan_Select() 从 main.c 移到 measure.c（改为 static）
    - 删除 main.c 中的 MEASURE_WAIT_TIMEOUT_MS 宏定义
    ## Phase 2: 搬测量周期
    - 在 measure.c 添加 Measure_Init() 函数
    - 包含：CircuitID_Init → Relay_Init → ADC_Sampler_Init → 首次扫描
    - 在 measure.c 添加 Measure_Service() 函数
    - 包含所有测量逻辑（频率获取、窗口等待、B1检测、计算、显示）
    - 添加内部状态变量（s_scan_request, s_range_request, s_scan_fail_count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
2026-10-28 修复按键处理的关键 bug：中断被永久关闭导致系统卡死
    ## 问题根源
    第一次按 b0 时，Screen_KeyEnqueue() 中：
    1. 进入 B0 分支，执行 __disable_irq()
    2. s_b0_pending == 0，没有执行 __set_PRIMASK(primask)
    3. 后面读到 PRIMASK=1（中断已关），再次 __disable_irq()
    4. 最后恢复成 1，中断仍然是关的
    5. 函数返回时，中断被永久关闭，系统卡死
    ## 修复方案
    重构 Screen_KeyEnqueue() 函数：
    - B0 判断、pending 检查、入队操作都在同一个临界区
    - 只关一次中断，只恢复一次中断
    - 所有 return 路径都会正确恢复中断
    ## 其他改进
    1. s_scan_aborted 生命周期完整化：
    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
2026-10-28 更新 README：反映当前版本架构和代码结构
    ## 主要更新
    ### 1. 版本号更新
    - v3.0 → v3.1（2026-10-28）
    ### 2. 工程结构说明（第 3 节）
    - measure.c 包含应用层循环（Measure_Init, Measure_Service）
    - screen.c 包含按键服务（Screen_KeyService）
    - main.c 只负责初始化和调用高层函数
    ### 3. 主循环架构（第 5 节）
    - 更新为三个高层调用：
    - Screen_KeyService(): 处理按键，设置请求标志
    - Measure_Service(): 执行扫描或测量周期
    - Screen_Poll(): 刷新屏幕
    - 按键行为说明：
    - b0: 重扫频率（合并/去重）
    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
2026-10-29 修复自动量程实现遗留问题；文档与自检脚本同步
    - Measure_ToggleAutoRange() 从死代码变为唯一实现（翻转状态 + 刷 t10 + 打日志），
    Measure_Service() 改为调用它，消除两份不一致的切换逻辑
    - 删除只写不读的 s_autorange_pending
    - MEASURE_AR_MAX_V 1.4 V → 1.5 V：1.41~1.5 V 区间原来会被强制降到低增益档、
    Uo 掉到 0.14 V，白丢约 10 倍信噪比；1.5 V 离 3.3 V 轨仍有 150 mV 余量
    - .gitignore: build-rev*/ → build*/（覆盖 build_autorange、build-rv 等临时目录）；
    新增 PLAN-*.md（计划文档作为工作稿，不进版本库）
    - .gitattributes: *.sh 强制 LF，避免 checkout 后 bash 因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
2026-10-29 重构测量状态机为非阻塞架构
    主要修改：
    - USE/relay_range.h/c: 新增非阻塞切档接口 (Relay_SetAsync/Relay_NextAsync)
    - USE/measure.h: 新增状态枚举和查询接口
    - USE/measure.c: 实现完整的状态机架构
    - IDLE/SWEEPING/SWITCHING/MEASURING 四个互斥状态
    - 消除所有阻塞点，主循环单次迭代 < 5ms
    - 按键响应时间从最多 5s 降低到 < 5ms
    - 删除 FreqScan_Select 阻塞版本，改用 FreqScanStep 状态机
    优化构建脚本：
    - .ccg-build/build.sh: 修复硬编码路径，自动获取项目根目录
    - .ccg-build/verify.sh: 更新编译器路径为 E:/Keil_v5/ARM/ARMCLANG/bin
    代码体积：53210 → 54514 (+1304 bytes)
    测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
2026-10-29 build.sh: 工具链路径改为自动探测，避免换机器就编不动
    原来硬编码 E:/Keil_v5/ARM/ARMCLANG/bin，而本机 Keil 装在 D:/KEIL/CORE，
    拉完代码直接 39 个文件全部 "armclang.exe: No such file or directory"。
    - 优先读环境变量 KEIL_ARMCLANG_BIN
    - 否则依次尝试 E:/Keil_v5、D:/KEIL/CORE、C:/Keil_v5
    - 都找不到时给出一条明确提示并退出，不再刷 39 条相同错误
2026-10-29 SPI1 改为从机 + DMA 循环接收；恢复 USART3 调试口
    - .ioc: SPI1 由 Master 改 Slave、软件 NSS 改硬件 NSS、加 SPI1_RX DMA
    （DMA1_Stream0 / Circular / HalfWord-HalfWord）
    - 重新启用 USART3：它在 fa7152f 之后就从 .ioc 里消失了，代码却还留着，
    这次生成把 usart.c/it.c/main.c 里的 USART3 一并删掉，uart_debug.c 编译失败；
    现在 .ioc 恢复 USART3（PB10 TX，921600）
    - Core/ 下 spi.c/usart.c/dma.c/gpio.c/it.c/main.c 按 .ioc 重新生成
    - verify.sh: 基准 Code=55474；继电器脚检查改成逐脚匹配（CubeMX 会重排引脚顺序）；
    新增 SPI1 从机/DMA 与 USART3 的检查项
    待硬件确认（不阻塞编译）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
2026-10-29 chore: SPI1 引脚速度提升至 VERY_HIGH，NSS 配置为硬件输入
    - PB5/PG9/PG11 GPIO 速度从 LOW 改为 VERY_HIGH（C3）
    - PG10 配置为 SPI1_NSS 硬件输入（C4）
    - 改进 9.375 MHz SPI 时钟下的边沿质量
    准备阶段：为 SPI 从机模式改造做准备
2026-10-29 feat: SPI1 从机模式 + FPGA 数据接收与 DFT 双路并行
    ## 功能概述
    将 SPI1 从主机模式改为从机模式，通过 DMA 循环接收 FPGA 推送的测量帧，
    与现有 ADC+DFT 测量结果并行比对，用于验证测量准确性。
    ## 主要改动
    ### 1. 新增模块（USE/spi_slave.h/.c）
    - SPI1 从机驱动：DMA 循环接收、CRC-16/CCITT-FALSE 校验、帧解析
    - 帧协议：10 字/帧（帧头 + 序号 + flags + 频率 + |H| + φ + CRC）
    - 调试输出：编译期分级宏（LEVEL=0/1/2/3），时间限流避免刷爆日志
    - 链路检测：200ms 无有效帧报 E21，自动重同步（连续 4 帧失败）
    ### 2. 测量流程集成（USE/measure.c）
    - Measur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
2026-10-29 fix: 修复编译错误和中断打印竞态
    ## P0 修复
    ### 1. 编译错误修复
    - uart_debug.c: y_mag → y_mag_siemens（字段名错误）
    - spi_slave.c: HAL_SPI_Abort_Receive → HAL_SPI_Abort（函数不存在）
    - spi_slave.c: 移除未使用的 #include <string.h>
    ### 2. 中断打印竞态修复（严重）
    原实现在 DMA 回调（中断上下文）里直接调用 UartDebug_Printf，
    与 UartDebug_Write 的临界区保护不兼容，导致：
    - 两个写者同时写 s_head 位置，日志行互相覆盖
    - s_head 可能倒退，导致 tail 越过 head，缓冲彻底错乱
    **修复方案 A（推荐）**：
    - 中断里只累加计数、记录事件到 volatile 变量
    - 主循环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
2026-10-29 fix: 修复事件队列设计缺陷和 SPIRAW 退化问题
    ## 🔴 A. 事件用单槽覆盖问题
    ### 问题
    原实现用单个 s_evt_type 槽位，新帧事件会覆盖之前的错误事件。
    只要有帧持续进来，中间偶发的 CRC 错误就会被下一个有效帧立刻覆盖，
    SPIERR crc 基本打不出来（而这正是联调时最需要看到的）。
    ### 修复
    改用位掩码 + 各自独立的数据槽：
    - s_err_flags: 错误标志位掩码（bit0 head, bit1 crc, bit2 nvalid, bit3 ovr）
    - s_err_head_w0/slot: head 错误数据
    - s_err_crc_seq/got/exp: crc 错误数据
    - s_err_nvalid_seq/fl: nvalid 错误数据
    - s_err_ovr_n: ovr 错误数据
    - s_new_frame_flag: 新帧只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
2026-10-29 fix: 修复事件队列竞态和数据不一致问题
    ## 修复内容
    ### 1. s_raw_ready 逻辑错误
    - 问题：读了 s_raw_ready 但没用，SPIRAW 打出别的帧的字
    - 修复：打印前检查 (new_frame) && (raw_ready)，只在打印成功后才清标志
    ### 2. 错误标志被节流窗口吞掉
    - 问题：临界区里读+清标志，节流窗口内的错误永久丢失
    - 修复：临界区里只读不清，只在真正打印后才清对应的 bit
    ### 3. s_new_frame_* 数据在临界区外读
    - 问题：只在临界区里读标志，数据在外面读，可能读到新帧的数据
    - 修复：临界区里把所有数据拷贝到局部变量，打印时只用局部变量
    ## 关键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
2026-10-29 fix: 清理未使用变量警告，优化标志清除时机
    ### 1. 未使用变量警告
    - 问题：默认 LEVEL=1 时，new_seq/new_fl/new_freq/new_mag/new_phi 拷贝了但没人用
    - 修复：把变量声明包进 #if SPI_SLAVE_DEBUG_LEVEL >= 2 里
    - 结果：默认编译无警告
    ### 2. s_new_frame_flag 清除时机
    - 问题：flag 在打印之后才清，期间来新帧会被这条清掉，丢失该帧的 SPIRX 日志
    - 修复：在读数据的同一临界区里清 flag
    - 结果：不会丢日志，且测量链路（s_have_new）不受影响
    ## 编译结果
    - 0 warning
    - 0 error
    - 40 files compiled successfully
    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
2026-10-29 docs: 补充 FPGA 对接关键细节
    ## 补充内容
    ### 1. CRC 字节序明确说明
    - 明确按线上字节序计算（大端），不是内存顺序（小端）
    - Cortex-M7 小端 vs SPI 线上 MSB first 的差异说明
    - 正确做法 vs 错误做法对比
    - 重要性：FPGA 按内存序算会导致帧头对、CRC 全错
    ### 2. CS 不能用来对齐帧
    - DMA 按字计数，4 帧循环，不靠 CS 对齐
    - 帧边界靠每帧固定 10 字维持
    - FPGA 必须保证 CS 拉低期间恰好发 160 个 SCK
    ### 3. 示例帧
    - 完整的示例帧（seq=1, f=1000, |H|=1.5, phi=-11.86 度）
    - 每个字段的数值解释
    - FPGA 侧可以拿来直接对拍
2026-10-29 fix: b1 切档响应延迟（MEASURING/SWEEPING 早退）
    ## 问题
    按 b1 切档，档位要等当前测量窗口跑完才变。
    测量频率越低越慢：10 kHz 几乎无感，1 kHz 约 0.1 s，100 Hz 约 1 s。
    ## 根因
    Screen_KeyService() 在主循环第①步就把 B1 从队列取走，
    Measure_Service() 第②步的 PeekKey() 看到的是空队列。
    s_range_request 虽然置位了，但要等状态机自己回到 IDLE 才轮到切档。
    延迟 = 一个完整 DFT 窗口（100 Hz 下 1 秒）。
    ## 修复
    在 Measure_Service() 的 MEASURING 和 SWEEPING 分支开头，
    各加一段发现切档请求就立刻退出的早退检查。
    退出到 IDLE 后，下一轮迭代由既有的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
2026-10-29 fix: 候选频率收敛到 2 档 + 扫描被打断后补扫
    1. 候选频率有 5 档（100/300/1000/3000/10000 Hz），但外部源只输出 1k/10k
    - 3 档永远不命中，每次扫描浪费 1.33 秒
    - 3 kHz 可能与 1 kHz 的 3 次谐波混淆
    2. 扫描被 b1 打断后，切档完成时用旧频率继续测
    - 若源频率已变 → kappa 低 → E14/E15 → 连续 3 次失败后自动重扫（0.4s 错误闪现）
    ### 1. 候选频率收敛到 2 档
    - USE/measure.c: s_sweep_candidates = {1000u, 10000u}
    - USE/screen.c: SCREEN_FREQ_COUNT = 2, s_freq_hz = {1000u, 10000u}
    - 扫描最坏耗时：~1.48s → ~0.11s（改善 13x）
    ### 2. 扫描被打断后自动补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
2026-10-29 docs: 更新 README 频率相关表述
    ## 更新内容（按计划 §8 要求）
    ### 第 13 行
    - 改前：固件自动在 **5 档频率** 中选择
    - 改后：固件自动在 **2 档频率（1 kHz / 10 kHz）** 中选择
    ### 第 212 行
    - 改前：候选顺序：1 kHz, 10 kHz, 3 kHz, 300 Hz, 100 Hz
    - 改后：候选顺序：1 kHz, 10 kHz
    ### 第 218 行
    - 改前：100 Hz 档窗口 1 s，扫描五档可能需要数秒
    - 改后：扫描两档约 0.11 s
    ### 第 557 行
    - 改前：100 Hz 窗口 1 s，重新扫描五档可能需要数秒
    - 改后：扫描两档约 0.11 s
    ### 保留不变
    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
2026-10-29 feat: 增加 SPI_SLAVE_ENABLE 总开关
    没接 FPGA 时屏幕会一直挂 E21（每周期都报一次），调试时容易被误认为故障。
    加一个编译期总开关，改成 0 即可整块关掉。
    - spi_slave.h: 新增 SPI_SLAVE_ENABLE（默认 1u）
    - spi_slave.c: 整个实现包进 #if/#else，关闭时提供 6 个空实现：
    - Spi_SlaveInit() 空（不启动 DMA）
    - Spi_SlavePoll() 恒返回 0
    - Spi_SlaveIsAlive() 恒返回 1 —— 关键：返回 0 会让 measure.c 每周期报 E21
    - 三个计数器恒返回 0
    - measure.c / uart_debug.c 无需任何条件编译
    实测两种配置均 0 error / 0 warning：
    SPI_SLAVE_ENABLE=1 → Code=58778（与改动前一致）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
2026-10-30 feat(spi): 适配 FPGA SPI 8位字节流传输、滑动重对齐与 top.v 测量帧解析
    - SPI1 从机与 DMA 接收对齐为 8-bit（Mode 3：CPOL=1, CPHA=1）
    - 重构 SPI 从机接收状态机为字节流滑动帧头搜索，彻底解决对齐丢失问题
    - 适配 FPGA top.v 帧协议（0x0708 帧头，0x0000 帧尾，PHASE/FREQ 计数值）
    - 实现 FPGA 频率/相对相位测值与单片机 ADC/DFT 结果的实时对比与打印
2026-10-30 feat(measure): 重构三档独立二维标定表、提升DFT抗噪深度至500周期并引入迟滞防抖自动量程
    - 实现 150Ω/1.5kΩ/15kΩ 三档随继电器切换自动调用的二维分档相频标定表
    - 完成 1 kHz 和 10 kHz 纯阻与复阻抗网络的精确闭环校准（电容/电阻测量误差收敛至 0.5%~3%，相位误差 < 0.3°）
    - 将 ADC_SAMPLER_WINDOW_CYCLES 提升至 500 周期，显著压低小信号与高阻抗噪声底
    - 自动量程引入施密特迟滞死区（需优于当前档40%才切档）、4窗口冷静期与削顶应急无延迟连环退档机制，杜绝继电器临界振荡横跳
